chaseab/so101-toolchanger/docs/future_tools/README.md

# Future tools

Tools designed for the changer: Jenga pusher JG2, hand HI5F, stamp STAMP2 and fin-ray gripper FR1. FR1 is built and runs on the changer; the other three are designs only. The focus of this repo is the tool changer itself, see the main README.
