chaseab/so101-toolchanger/docs/future_tools/fr1_exploded.png

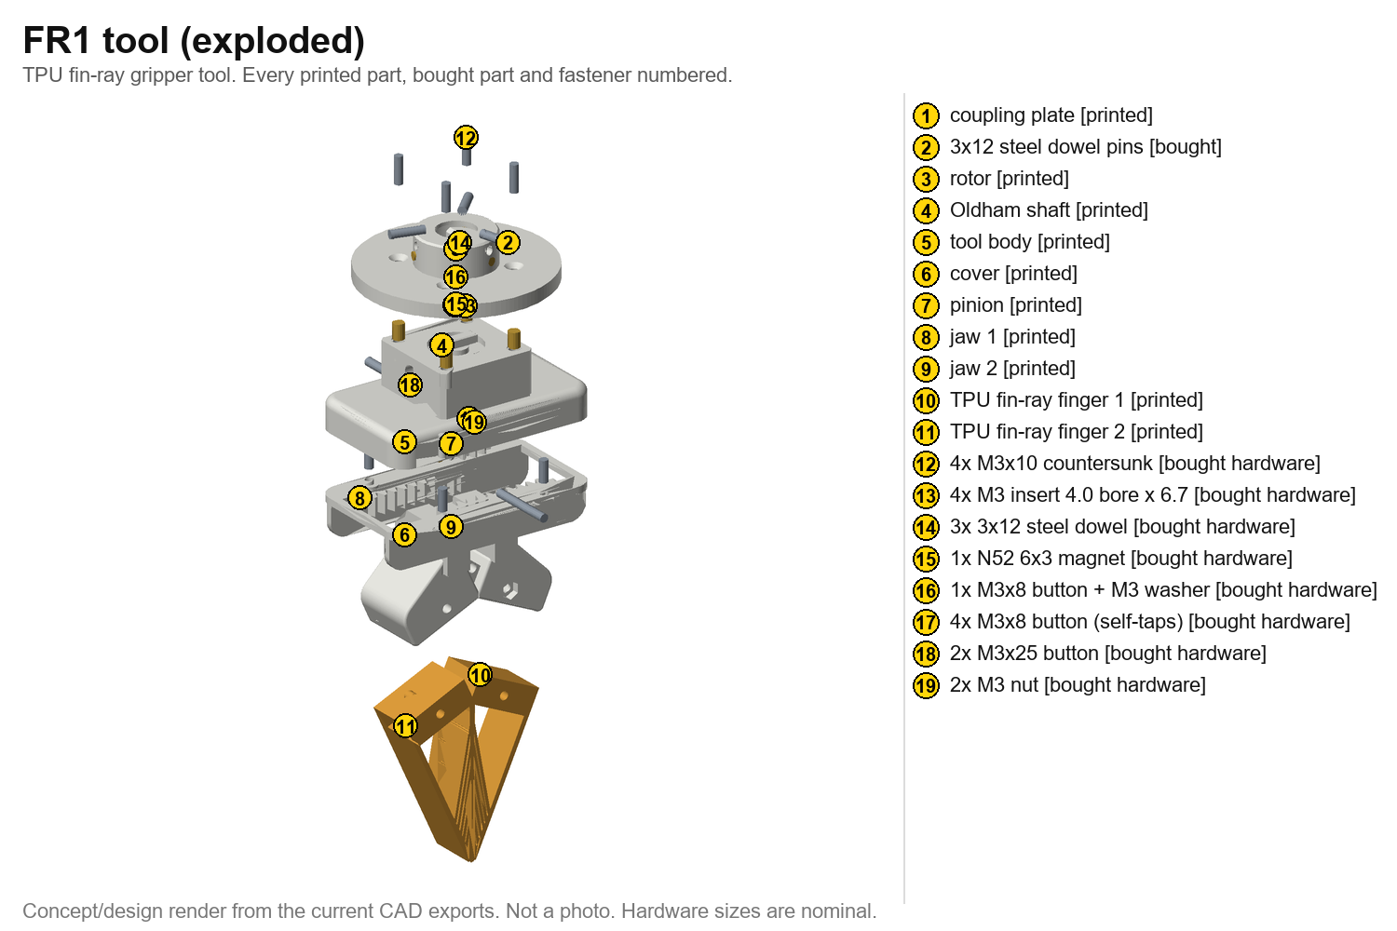
docs/future_tools/fr1_exploded.png
