chaseab/so101-toolchanger/docs/future_tools/hi5f_exploded.png

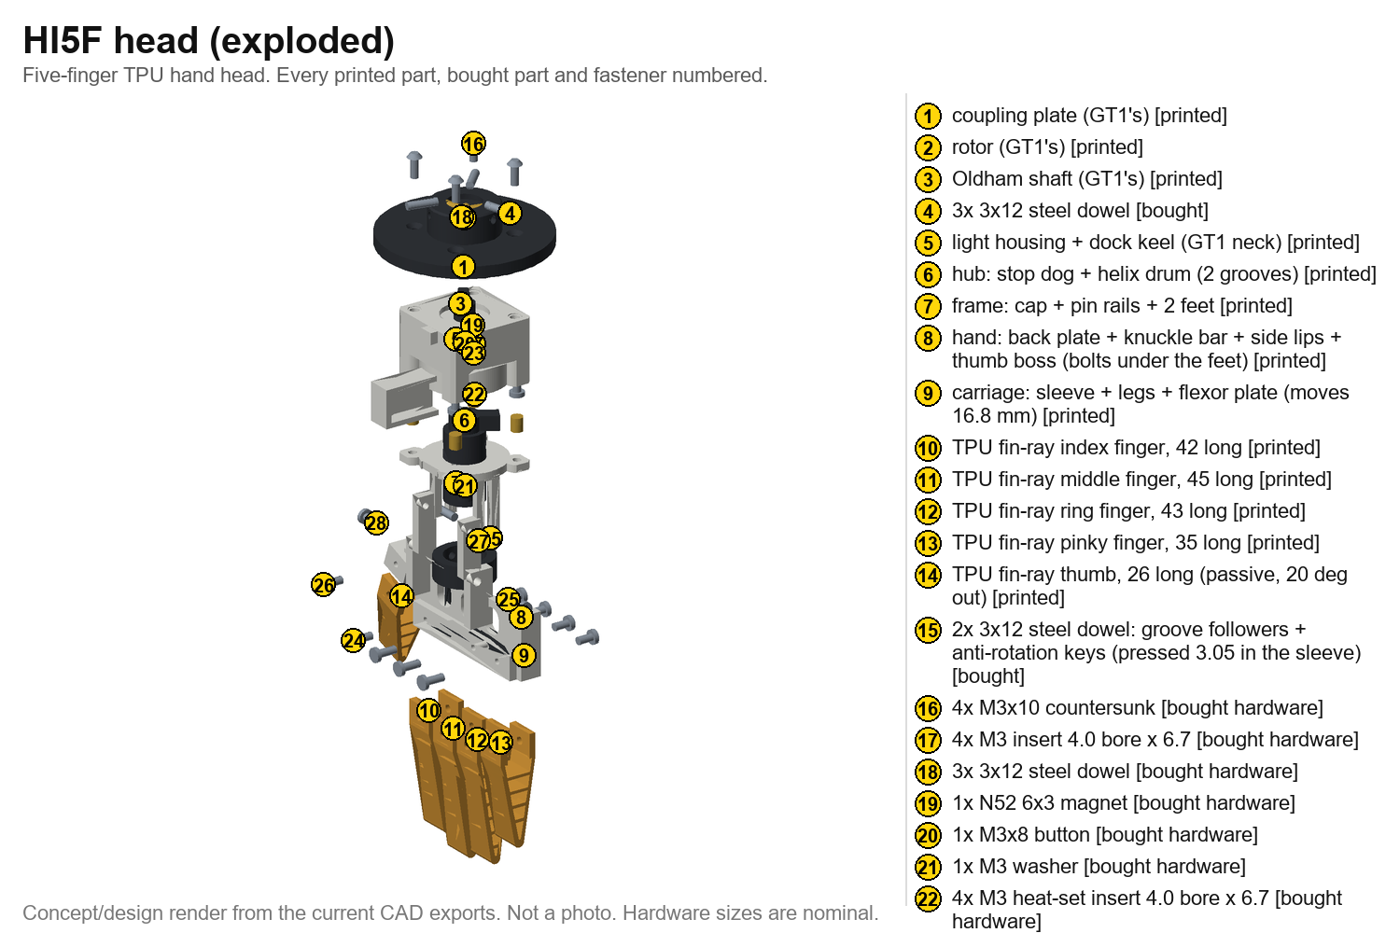
docs/future_tools/hi5f_exploded.png
