chaseab/so101-toolchanger/docs/future_tools/jg2_exploded.png

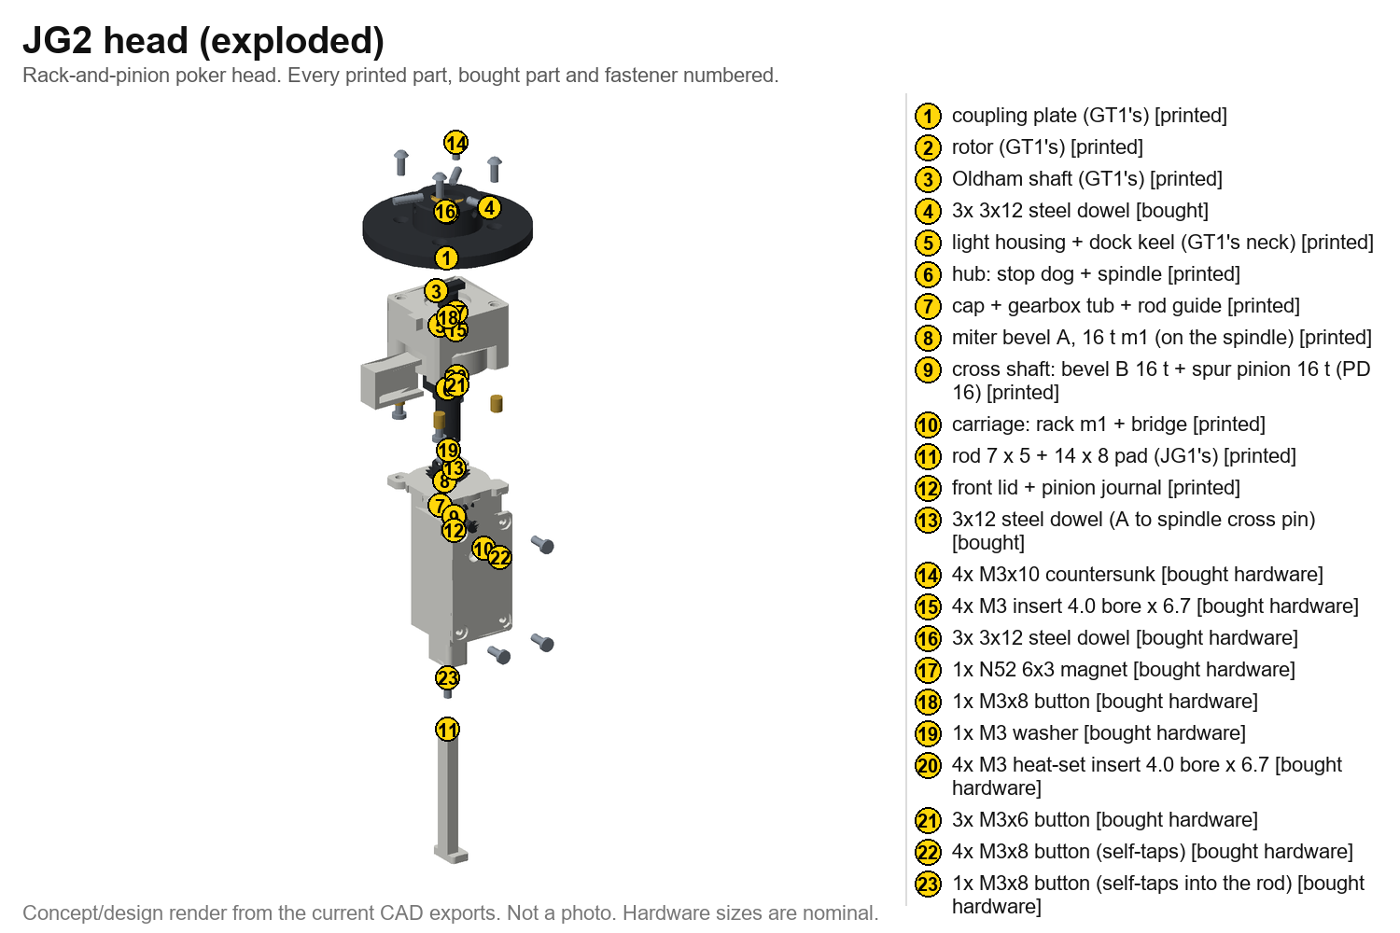
docs/future_tools/jg2_exploded.png
