chaseab/so101-toolchanger/docs/future_tools/stamp2_exploded.png

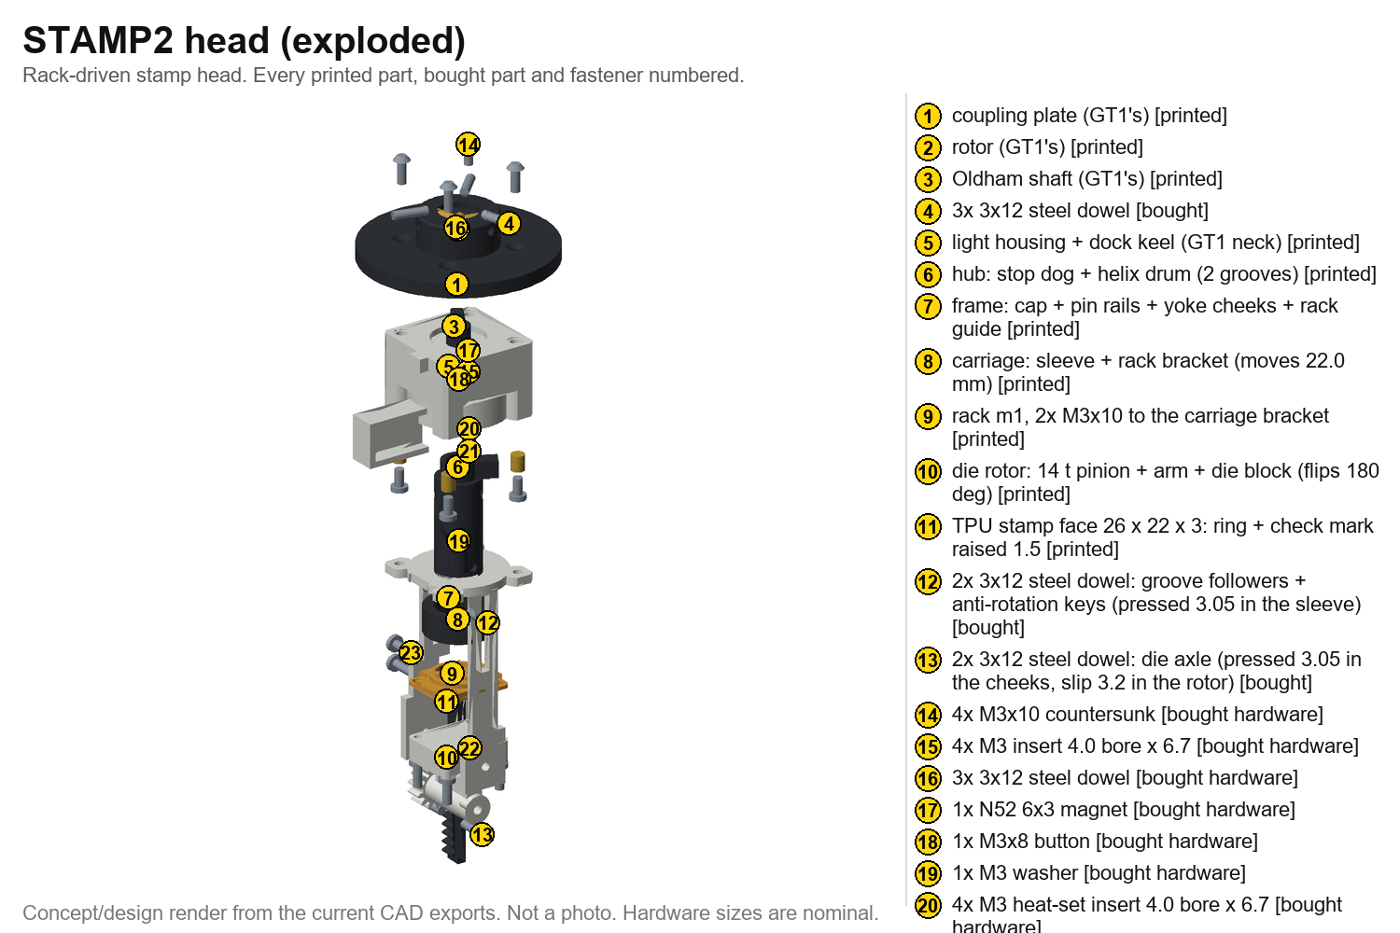
docs/future_tools/stamp2_exploded.png
