chaseab/so101-toolchanger/docs/BOM.csv

section | part_id | part | qty | spec | used_for | source_type | vendor | link | exact_url | generic_url | search_q | grams_each | filament | approx_price_usd
A | tc-so101-arm | SO-101 arm (follower), TheRobotStudio design | 1 | SO-ARM100 / SO-101 repo: printed parts, STS3215 servos, controller board | the arm the changer mounts on | upstream | TheRobotStudio | https://logicframeco.com/go/tc-so101-arm/github | https://github.com/TheRobotStudio/SO-ARM100 |  |  |  |  | ~
A | tc-dowel-3x12 | Steel dowel pin, plain cylindrical 3 mm x 12 mm (pack of 50) | 9 | 3 mm dia x 12 mm, 304 stainless, unthreaded | steel V-seats on the arm-side ring (6) and the pins on the tool coupler plate (3) | bought | Amazon (MroMax) | https://logicframeco.com/go/tc-dowel-3x12/github | https://www.amazon.com/dp/B07ZF3478S | https://www.amazon.com/s?k=3mm+x+12mm+stainless+steel+dowel+pins+50+pcs | 3mm x 12mm stainless steel dowel pins 50 pcs |  |  | 5.99
A | tc-magnet-n52-6x3 | N52 neodymium disc magnet 6 mm x 3 mm (pack of 50) | 2 | 6 x 3 mm, N52 | one in the tool neck and one in the dock floor, so a parked tool is not dragged out | bought | Amazon | https://logicframeco.com/go/tc-magnet-n52-6x3/github | https://www.amazon.com/dp/B0GWM33Z8X | https://www.amazon.com/s?k=N52+neodymium+disc+magnets+6x3mm+50+pcs | N52 neodymium disc magnets 6x3mm 50 pcs |  |  | 14.59
A | tc-ball-5-32 | Chrome steel ball 5/32 in (3.97 mm), G25 (pack of 100) | 3 | 5/32 in, G25 chrome steel, non-magnetic | tips of the three spring plungers on the arm side | bought | Amazon (PGN) | https://logicframeco.com/go/tc-ball-5-32/github | https://www.amazon.com/dp/B07D9SHZRZ | https://www.amazon.com/s?k=5%2F32+inch+G25+chrome+steel+balls+100+pcs | 5/32 inch G25 chrome steel balls 100 pcs |  |  | 7.95
A | tc-spring-5x0.7x10 | Compression spring 5 mm OD x 0.7 mm wire x 10 mm free (pack of 10) | 3 | 5 mm OD, 0.7 mm wire, 10 mm free, 304 stainless; about 10 N at 8.05 mm | push the three plungers (and the tool plate back) in the twist-lock | bought | Amazon (MECCANIXITY) | https://logicframeco.com/go/tc-spring-5x0.7x10/github | https://www.amazon.com/dp/B0DX21BNJM | https://www.amazon.com/s?k=compression+spring+5mm+OD+0.7mm+wire+10mm+free+length | compression spring 5mm OD 0.7mm wire 10mm free length |  |  | 6.59
A | tc-m3x10-csk | M3 x 10 countersunk (flat head) hex socket screw, 90 deg (pack of 50) | 8 | M3 x 10, 304 stainless, countersunk | hold the coupling plate to the tool neck (4) and the clamp bars to the dock frame (4) | bought | Amazon | https://logicframeco.com/go/tc-m3x10-csk/github | https://www.amazon.com/dp/B0H3GL2FSM | https://www.amazon.com/s?k=M3+x+10+countersunk+flat+head+hex+socket+screws | M3 x 10 countersunk flat head hex socket screws |  |  | 5.99
A | tc-m3-heat-insert-4.0x6.7 | M3 brass heat-set insert, 4.0 bore x 6.7 L | 15 | M3 thread, 4.0 mm bore, 6.7 mm long | threaded holes in the arm-side hub, ring and cage (7), the tool neck (4) and the dock frame (4) | generic | Amazon (FFVRVSS 600-pc set) | https://logicframeco.com/go/tc-m3-heat-insert-4.0x6.7/github | none | https://www.amazon.com/s?k=M3+x+5.7+x+4+brass+heat+set+insert | M3 x 5.7 x 4 brass heat set insert |  |  | ~
A | tc-m3-button-master | M3 button-head socket screw, 5 to 8 mm (kit) | 13 | M3 ISO 7380 button head: 4x M3x6 (hub to roll horn), 5x M3x8 (ring to cage, strap), 4x M3x5 (carrier to gripper horn) | hold the arm-side parts together | generic | Amazon (Fgruh M2-M5 kit) | https://logicframeco.com/go/tc-m3-button-master/github | none | https://www.amazon.com/s?k=M3+button+head+socket+screws+assortment+kit | M3 button head socket screws assortment kit |  |  | ~
A | tc-m3x40-socket | M3 x 40 socket head cap screw | 2 | M3 x 40 hex socket | hold the servo cage up into the hub (2) | generic | Amazon (NIULUNBAO M3 20-40 mm kit) | https://logicframeco.com/go/tc-m3x40-socket/github | none | https://www.amazon.com/s?k=M3+x+40mm+socket+head+cap+screws | M3 x 40mm socket head cap screws |  |  | ~
A | tc-vhb-tape-disc | Double-sided tape disc D10 x 0.4 mm | 2 | 10 mm dia x 0.4 mm, cut from 1 in tape | stick the dock stop pads to the dock wall | generic | Amazon (Hasaky tape) | https://logicframeco.com/go/tc-vhb-tape-disc/github | none | https://www.amazon.com/s?k=double+sided+mounting+tape+1+inch+0.4mm | double sided mounting tape 1 inch 0.4mm |  |  | ~
A | tc-vhb-tape-strip | Double-sided tape strip 23.6 x 14.8 x 0.4 mm | 2 | 23.6 x 14.8 x 0.4 mm, cut from 1 in tape | stick the dock cradle columns to the dock foot | generic | Amazon (Hasaky tape) | https://logicframeco.com/go/tc-vhb-tape-strip/github | none | https://www.amazon.com/s?k=double+sided+mounting+tape+1+inch+0.4mm | double sided mounting tape 1 inch 0.4mm |  |  | ~
A | tc-ptfe-grease | PTFE grease, 0.75 oz tube | 1 | all-purpose PTFE grease | light coat on the locking surfaces | generic | Amazon (Magnalube-G) | https://logicframeco.com/go/tc-ptfe-grease/github | none | https://www.amazon.com/s?k=Super+Lube+PTFE+grease+small+tube | Super Lube PTFE grease small tube |  |  | 11.99
A | tc-ca-glue | Cyanoacrylate gel glue | 1 | clear CA gel | glue the steel dowels and the lead-in skirt | generic | Amazon (Loctite Ultra Gel) | https://logicframeco.com/go/tc-ca-glue/github | none | https://www.amazon.com/s?k=Loctite+super+glue+ultra+gel | Loctite super glue ultra gel |  |  | 4.73
A | tc-pla-black | PLA filament 1.75 mm, black (2 x 1 kg) | 1 | 1.75 mm PLA | most printed parts | bought | Amazon (ELEGOO) | https://logicframeco.com/go/tc-pla-black/github | https://www.amazon.com/dp/B0BM7465PB | https://www.amazon.com/s?k=ELEGOO+PLA+filament+1.75mm+black | ELEGOO PLA filament 1.75mm black |  |  | 23.73
A | tc-pla-white | PLA filament 1.75 mm, white | 1 | 1.75 mm PLA | dock retrofit kit prints | generic | Amazon (ELEGOO black/white 4 kg) | https://logicframeco.com/go/tc-pla-white/github | none | https://www.amazon.com/s?k=ELEGOO+PLA+filament+1.75mm+white | ELEGOO PLA filament 1.75mm white |  |  | ~
A | tc-tpu-95a | TPU 95A filament 1.75 mm | 1 | 1.75 mm TPU 95A | the two small pads on the arm-side servo cage | generic | Amazon (Polymaker) | https://logicframeco.com/go/tc-tpu-95a/github | none | https://www.amazon.com/s?k=Polymaker+TPU+95A+1.75mm+filament+black | Polymaker TPU 95A 1.75mm filament black |  |  | ~
A | tc-master-master-hub-v4 | Hub | 1 | printed, ~11.6 g PLA each | arm side: bolts to the wrist-roll horn | printed |  | stl/master_v4/master_hub_v4.stl |  |  |  | 11.6 | PLA | ~
A | tc-master-master-cage-v4 | Servo cage | 1 | printed, ~35.6 g PLA each | arm side: holds the gripper servo | printed |  | stl/master_v4/master_cage_v4.stl |  |  |  | 35.6 | PLA | ~
A | tc-master-master-strap-v4 | Hold-down strap | 1 | printed, ~2.4 g PLA each | arm side: holds the servo in the cage | printed |  | stl/master_v4/master_strap_v4.stl |  |  |  | 2.4 | PLA | ~
A | tc-master-master-carrier-v4 | Blade carrier | 1 | printed, ~1.8 g PLA each | arm side: the blade that turns the tool rotor | printed |  | stl/master_v4/master_carrier_v4.stl |  |  |  | 1.8 | PLA | ~
A | tc-master-master-ring-v4q | Coupling ring | 1 | printed, ~45.5 g PLA each | arm side: the three V-seats and windows of the twist-lock | printed |  | stl/master_v4/master_ring_v4q.stl |  |  |  | 45.5 | PLA | ~
A | tc-master-master-skirt-v4 | Lead-in skirt | 1 | printed, ~13.4 g PLA each | arm side: guides the tool plate in | printed |  | stl/master_v4/master_skirt_v4.stl |  |  |  | 13.4 | PLA | ~
A | tc-master-master-backpad-tpu-v4 | Back pad | 1 | printed, ~1.0 g TPU each | arm side: stops the servo lifting | printed |  | stl/master_v4/master_backpad_TPU_v4.stl |  |  |  | 1.0 | TPU | ~
A | tc-master-master-farpad-tpu-v4 | Far pad shim | 1 | printed, ~0.2 g TPU each | arm side: shim under the strap | printed |  | stl/master_v4/master_farpad_TPU_v4.stl |  |  |  | 0.2 | TPU | ~
A | tc-master-master-plunger0-v4b | Ball plunger (3 identical; the other two STLs are the same part at the other seats) | 3 | printed, ~0.2 g PLA each | arm side: carries the steel ball and spring | printed |  | stl/master_v4/master_plunger0_v4b.stl |  |  |  | 0.2 | PLA | ~
A | tc-gt1-gt-plate | Coupling plate | 1 | printed, ~25.3 g PLA each | tool coupler: the plate with the three pins that locks into the ring | printed |  | stl/tool_gt1/gt_plate.stl |  |  |  | 25.3 | PLA | ~
A | tc-gt1-gt-rotor | Floating rotor | 1 | printed, ~3.8 g PLA each | tool coupler: the arm blade drives this | printed |  | stl/tool_gt1/gt_rotor.stl |  |  |  | 3.8 | PLA | ~
A | tc-gt1-gt-shaft | Drive shaft | 1 | printed, ~1.5 g PLA each | tool coupler: carries the rotor turn into the tool | printed |  | stl/tool_gt1/gt_shaft.stl |  |  |  | 1.5 | PLA | ~
A | tc-dock-dock-post-asbuilt | Dock post (the same part is also exported as dock_post_v4) | 1 | printed, ~326.3 g PLA each | dock: the slotted wall that parks the tool | printed |  | stl/dock_v5/dock_post_asbuilt.stl |  |  |  | 326.3 | PLA | ~
A | tc-dock-db-frame | Dock table frame | 1 | printed, ~86.9 g PLA each | dock: base that clamps to the table | printed |  | stl/master_v4/db_frame.stl |  |  |  | 86.9 | PLA | ~
A | tc-dock-db-bar-front | Front clamp bar | 1 | printed, ~25.1 g PLA each | dock: clamps the post, arm side | printed |  | stl/master_v4/db_bar_front.stl |  |  |  | 25.1 | PLA | ~
A | tc-dock-db-bar-back | Back clamp bar | 1 | printed, ~17.5 g PLA each | dock: clamps the post, back side | printed |  | stl/master_v4/db_bar_back.stl |  |  |  | 17.5 | PLA | ~
A | tc-dock-v5-cradle-col-l | R1 cradle column, left | 1 | printed, ~23.7 g PLA each | dock R1 kit: guides the tool body into the dock | printed |  | stl/dock_v5/cradle_col_L.stl |  |  |  | 23.7 | PLA | ~
A | tc-dock-v5-cradle-col-r | R1 cradle column, right | 1 | printed, ~23.7 g PLA each | dock R1 kit: guides the tool body into the dock | printed |  | stl/dock_v5/cradle_col_R.stl |  |  |  | 23.7 | PLA | ~
A | tc-dock-v5-stop-pad | R1 stop pad, D10 round (2 needed) | 2 | printed, ~0.2 g PLA each | dock R1 kit: sets the plate gap to the wall | printed |  | stl/dock_v5/stop_pad.stl |  |  |  | 0.2 | PLA | ~
A | tc-dock-v5-t-gauge | R1 T-gauge (one-time alignment template) | 1 | printed, ~19.6 g PLA each | dock R1 kit: lines the dock up with the arm | printed |  | stl/dock_v5/t_gauge.stl |  |  |  | 19.6 | PLA | ~
B | tc-dowel-3x12 | Steel dowel pin, plain cylindrical 3 mm x 12 mm (pack of 50) | 3 | 3 mm dia x 12 mm, 304 stainless, unthreaded | the three pins on the new tool's coupler plate | bought | Amazon (MroMax) | https://logicframeco.com/go/tc-dowel-3x12/github | https://www.amazon.com/dp/B07ZF3478S | https://www.amazon.com/s?k=3mm+x+12mm+stainless+steel+dowel+pins+50+pcs | 3mm x 12mm stainless steel dowel pins 50 pcs |  |  | 5.99
B | tc-magnet-n52-6x3 | N52 neodymium disc magnet 6 mm x 3 mm (pack of 50) | 1 | 6 x 3 mm, N52 | one in the new tool's neck | bought | Amazon | https://logicframeco.com/go/tc-magnet-n52-6x3/github | https://www.amazon.com/dp/B0GWM33Z8X | https://www.amazon.com/s?k=N52+neodymium+disc+magnets+6x3mm+50+pcs | N52 neodymium disc magnets 6x3mm 50 pcs |  |  | 14.59
B | tc-m3x10-csk | M3 x 10 countersunk (flat head) hex socket screw, 90 deg (pack of 50) | 4 | M3 x 10, 304 stainless, countersunk | hold the coupling plate to the new tool's neck | bought | Amazon | https://logicframeco.com/go/tc-m3x10-csk/github | https://www.amazon.com/dp/B0H3GL2FSM | https://www.amazon.com/s?k=M3+x+10+countersunk+flat+head+hex+socket+screws | M3 x 10 countersunk flat head hex socket screws |  |  | 5.99
B | tc-m3-heat-insert-4.0x6.7 | M3 brass heat-set insert, 4.0 bore x 6.7 L | 4 | M3 thread, 4.0 mm bore, 6.7 mm long | threaded holes in the new tool's neck | generic | Amazon (FFVRVSS 600-pc set) | https://logicframeco.com/go/tc-m3-heat-insert-4.0x6.7/github | none | https://www.amazon.com/s?k=M3+x+5.7+x+4+brass+heat+set+insert | M3 x 5.7 x 4 brass heat set insert |  |  | ~
B | tc-gt1-gt-plate | Coupling plate | 1 | printed, ~25.3 g PLA each | tool coupler: the plate with the three pins that locks into the ring | printed |  | stl/tool_gt1/gt_plate.stl |  |  |  | 25.3 | PLA | ~
B | tc-gt1-gt-rotor | Floating rotor | 1 | printed, ~3.8 g PLA each | tool coupler: the arm blade drives this | printed |  | stl/tool_gt1/gt_rotor.stl |  |  |  | 3.8 | PLA | ~
B | tc-gt1-gt-shaft | Drive shaft | 1 | printed, ~1.5 g PLA each | tool coupler: carries the rotor turn into the tool | printed |  | stl/tool_gt1/gt_shaft.stl |  |  |  | 1.5 | PLA | ~
C | tc-heat-insert-m3-5.0x4 | M3 brass heat-set insert, 5.0 OD x 4 L | 4 | M3 thread, 5.0 OD, 4 long | attach the optional R2 dock head (4) | generic | Amazon (FFVRVSS 600-pc set) | https://logicframeco.com/go/tc-heat-insert-m3-5.0x4/github | none | https://www.amazon.com/s?k=M3+x+4+brass+heat+set+insert+5mm+OD | M3 x 4 brass heat set insert 5mm OD |  |  | ~
C | tc-m3x10-button | M3 x 10 button-head socket screw | 4 | M3 x 10 ISO 7380 | attach the optional R2 dock head (4) | generic | Amazon (Fgruh M2-M5 kit) | https://logicframeco.com/go/tc-m3x10-button/github | none | https://www.amazon.com/s?k=M3+x+10+button+head+socket+screws | M3 x 10 button head socket screws |  |  | ~
C | tc-dock-v5-head-r2 | Optional R2 dock head (needs one jigsaw cut) | 1 | printed, ~79.3 g PLA each | optional dock head that replaces the old wall top | printed |  | stl/dock_v5/head_R2.stl |  |  |  | 79.3 | PLA | ~
