chaseab/so101-toolchanger/step/dock_v5/cradle_col_L.step

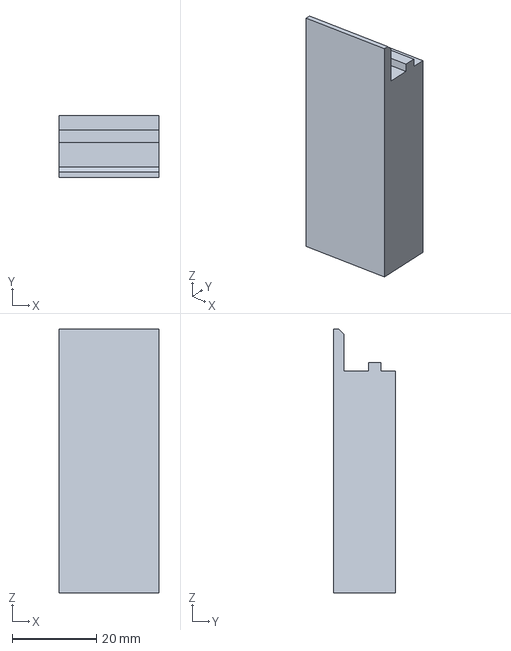
[picture p10: CAD file, 2026-10-30]
step/dock_v5/cradle_col_L.step
23.6 x 14.8 x 62.6 mm
