chaseab/so101-toolchanger/step/heads/jg2.step

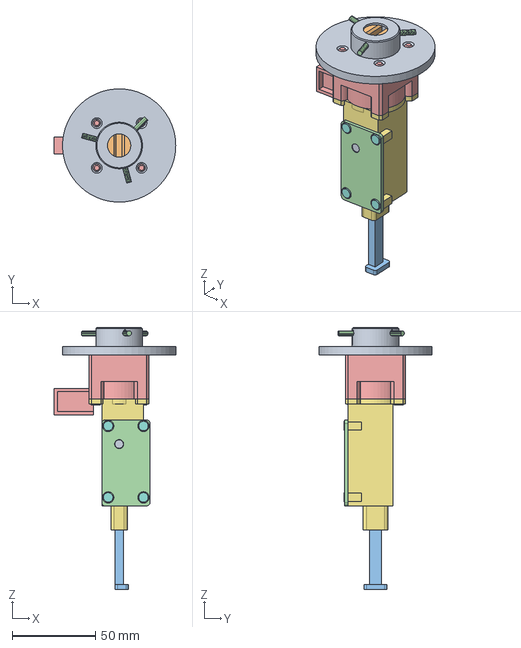
[picture p11: CAD file, 2026-10-30]
step/heads/jg2.step
73.0 x 68.0 x 157.3 mm
