chaseab/so101-toolchanger/step/master_v4/master_ring_v4.step

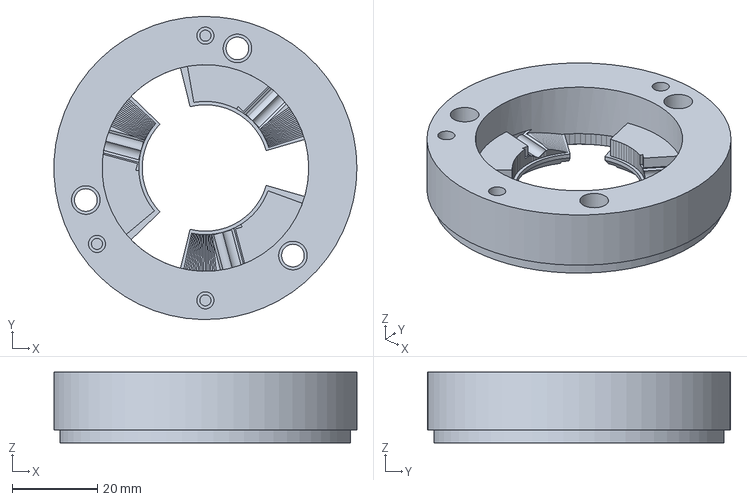
[picture p12: CAD file, 2026-10-30]
step/master_v4/master_ring_v4.step
70.9 x 71.0 x 16.5 mm
