chaseab/so101-toolchanger/step/tool_fr1/fr1.step

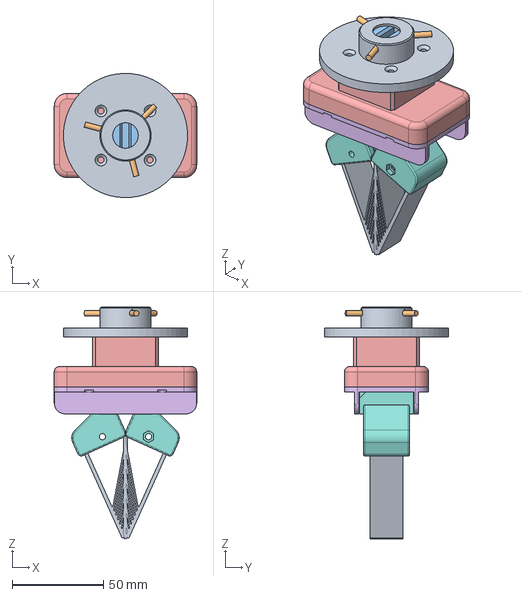
[picture p13: CAD file, 2026-10-30]
step/tool_fr1/fr1.step
78.0 x 68.0 x 127.0 mm
