chaseab/so101-toolchanger/stl/dock_v5/stop_pad_L.stl

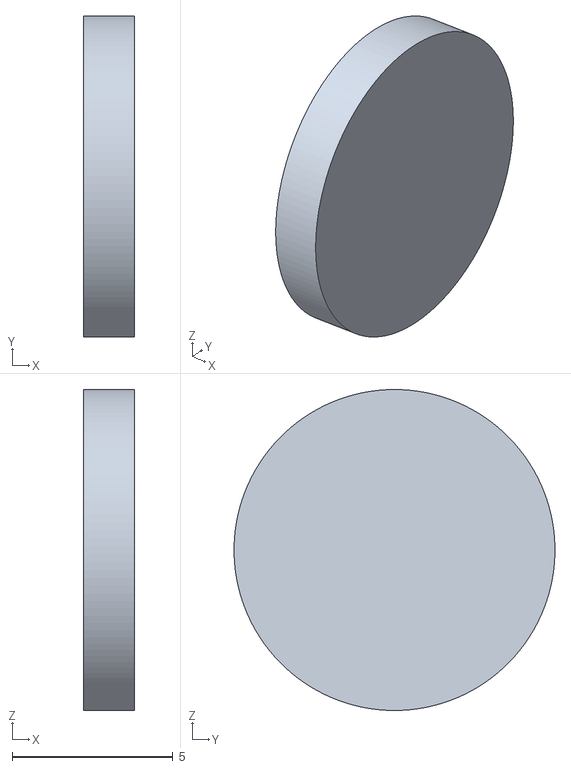
[picture p14: CAD file, 2026-10-30]
stl/dock_v5/stop_pad_L.stl
1.58 x 10.00 x 10.0
