chaseab/so101-toolchanger/stl/heads_hi5f/f_ring_closed.stl

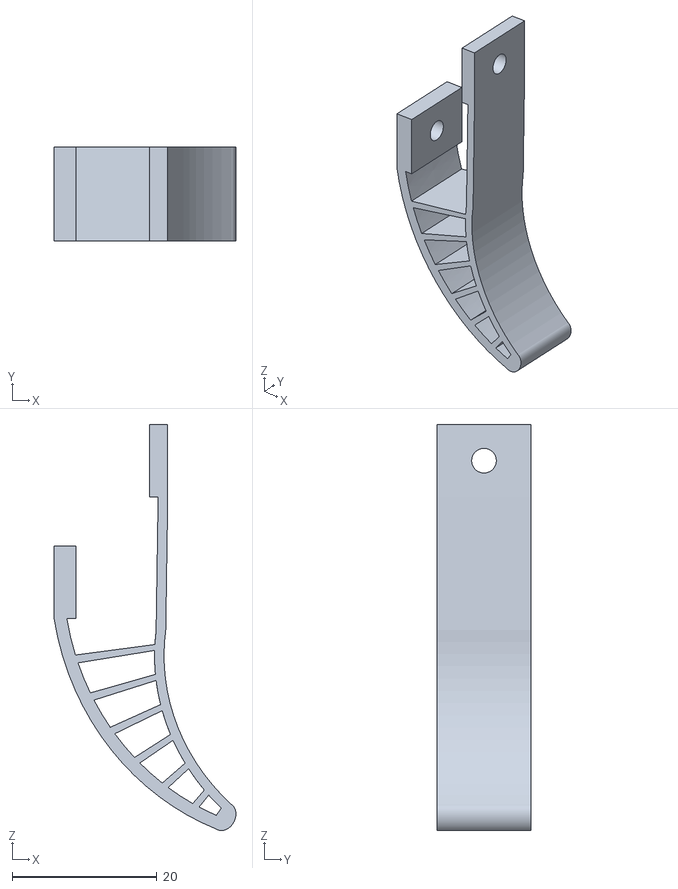
[picture p15: CAD file, 2026-10-30]
stl/heads_hi5f/f_ring_closed.stl
25.1 x 13.0 x 56.1
