chaseab/so101-toolchanger/stl/heads_jg2/pinion_unit.stl

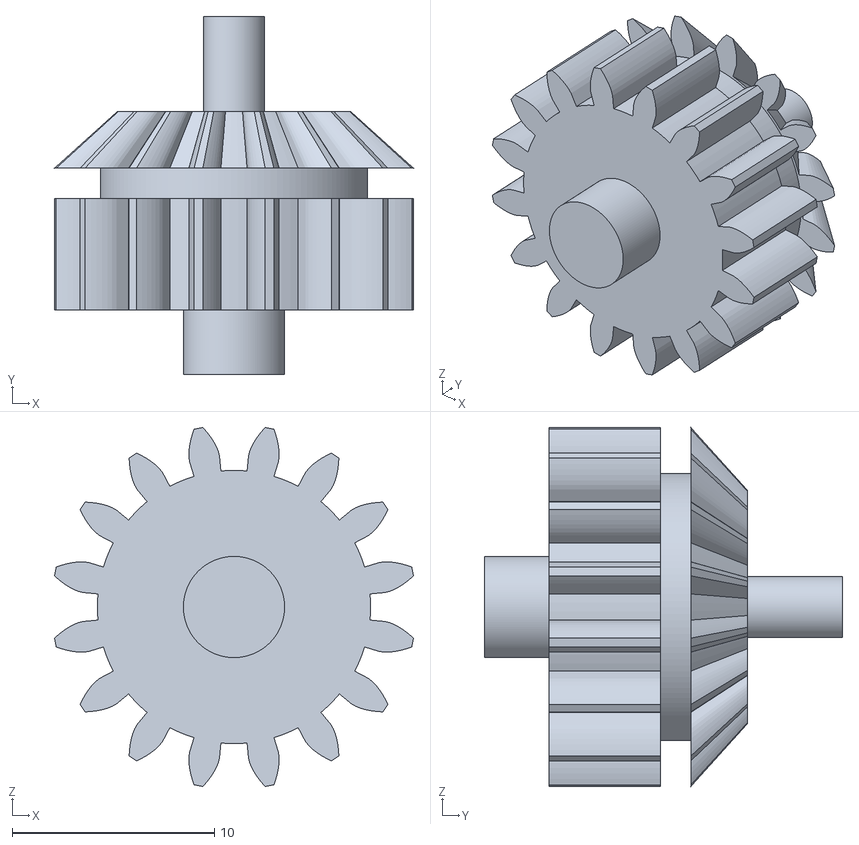
[picture p16: CAD file, 2026-10-30]
stl/heads_jg2/pinion_unit.stl
17.7 x 17.7 x 17.7
