chaseab/so101-toolchanger/stl/heads_stamp2/die_cap.stl

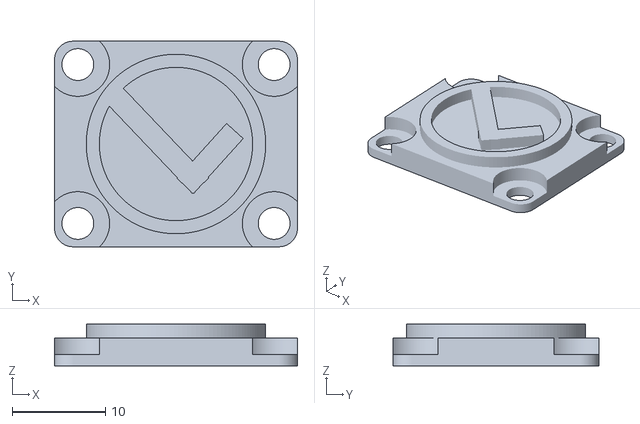
[picture p17: CAD file, 2026-10-30]
stl/heads_stamp2/die_cap.stl
26.0 x 22.0 x 4.49
