chaseab/so101-toolchanger/stl/master_v4/db_frame.stl

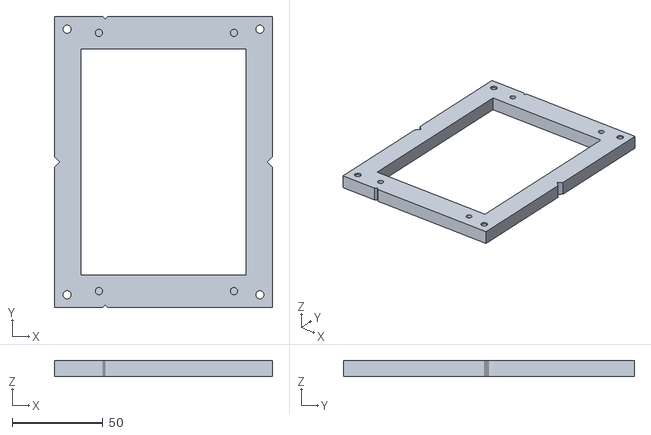
[picture p18: CAD file, 2026-10-30]
stl/master_v4/db_frame.stl
120.0 x 160.0 x 9.00
