chaseab/so101-toolchanger/stl/tool_fr1/jaw2_open.stl

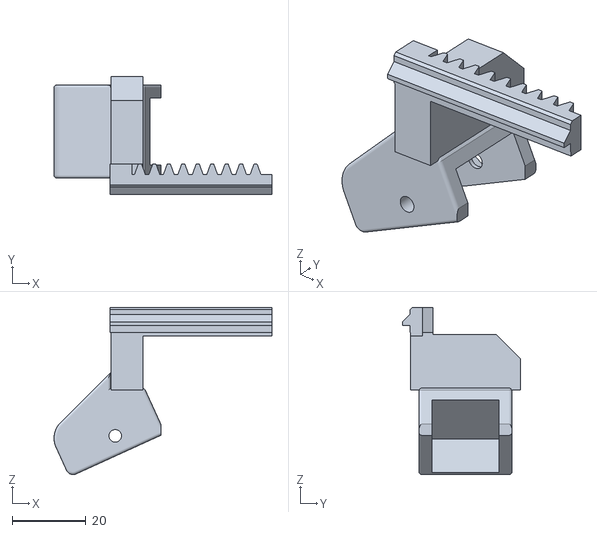
[picture p19: CAD file, 2026-10-30]
stl/tool_fr1/jaw2_open.stl
59.2 x 32.0 x 45.4
