chaseab/so101-toolchanger/stl/tool_gt1/gt_body.stl

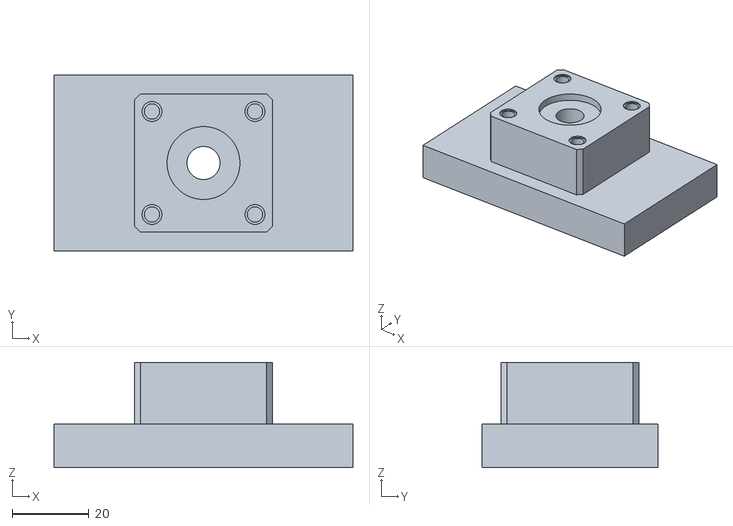
[picture p20: CAD file, 2026-10-30]
stl/tool_gt1/gt_body.stl
78.0 x 46.0 x 27.4
