chaseab/so101-toolchanger/step/heads/stamp2.step

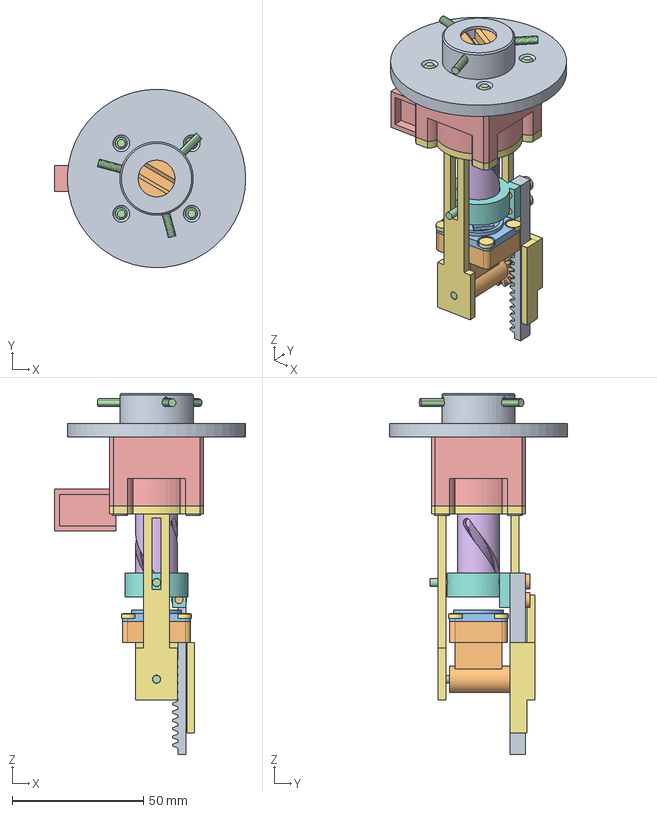
[picture p21: CAD file, 2026-10-30]
step/heads/stamp2.step
73.0 x 68.0 x 137.7 mm
