chaseab/so101-toolchanger/step/master_v4/dock_post_v4.step

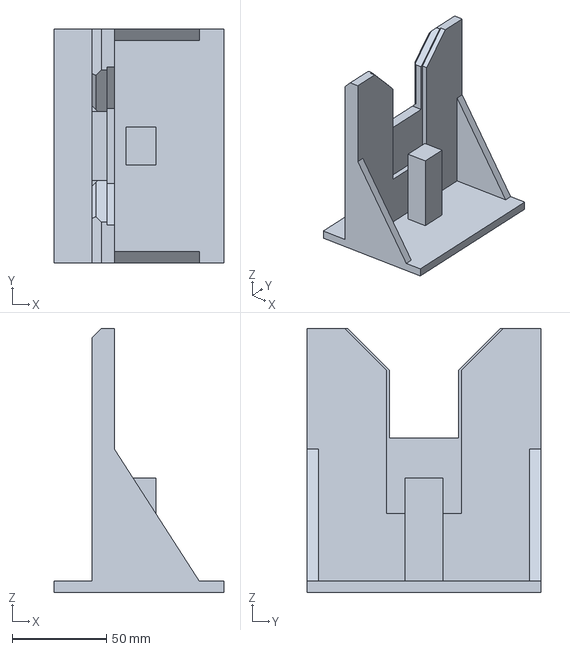
[picture p22: CAD file, 2026-10-30]
step/master_v4/dock_post_v4.step
90.0 x 124.0 x 140.0 mm
