chaseab/so101-toolchanger/stl/heads_hi5f/plate.stl

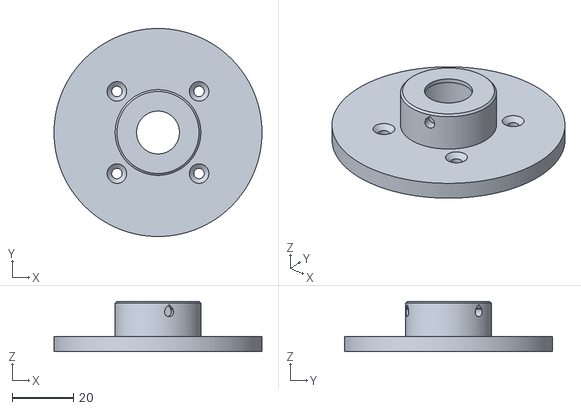
[picture p23: CAD file, 2026-10-30]
stl/heads_hi5f/plate.stl
68.0 x 68.0 x 16.5
