chaseab/so101-toolchanger/stl/heads_jg2/rod_ret.stl

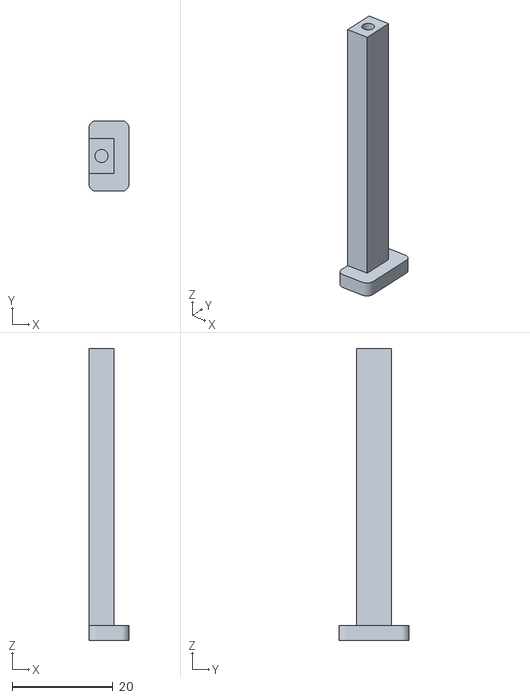
[picture p24: CAD file, 2026-10-30]
stl/heads_jg2/rod_ret.stl
8.00 x 14.0 x 58.0
