chaseab/so101-toolchanger/stl/heads_stamp2/hw_housing_insert1.stl

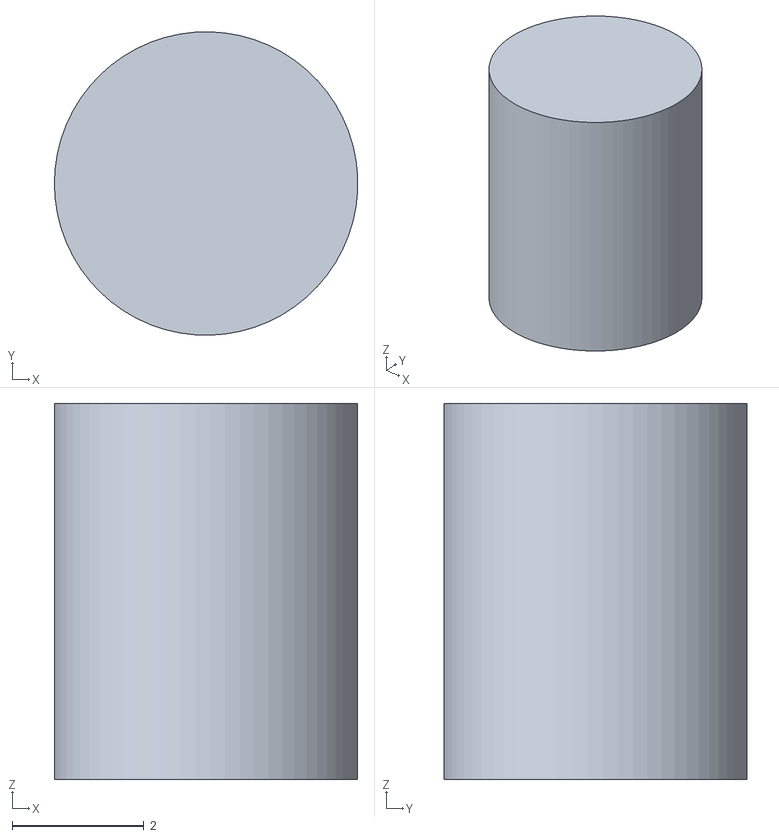
[picture p25: CAD file, 2026-10-30]
stl/heads_stamp2/hw_housing_insert1.stl
4.60 x 4.60 x 5.70
