chaseab/so101-toolchanger/stl/tool_fr1/pins.stl

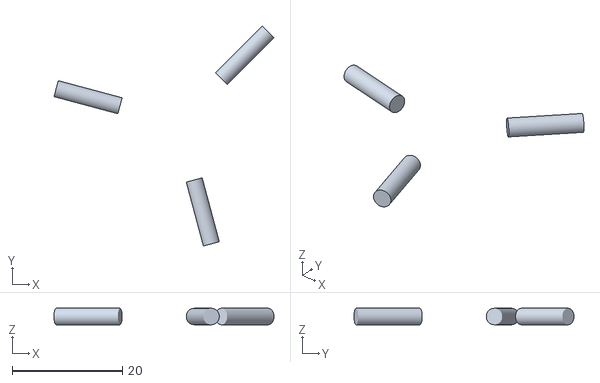
[picture p26: CAD file, 2026-10-30]
stl/tool_fr1/pins.stl
39.9 x 39.9 x 3.00
