chaseab/so101-toolchanger/stl/tool_gt1/gt_jaw1.stl

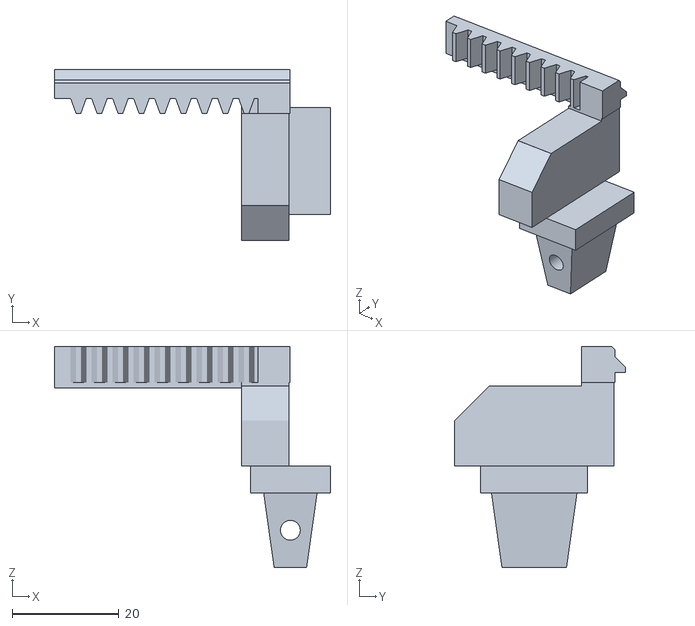
[picture p27: CAD file, 2026-10-30]
stl/tool_gt1/gt_jaw1.stl
51.6 x 32.0 x 41.4
