chaseab/so101-toolchanger/step/heads/hi5f.step

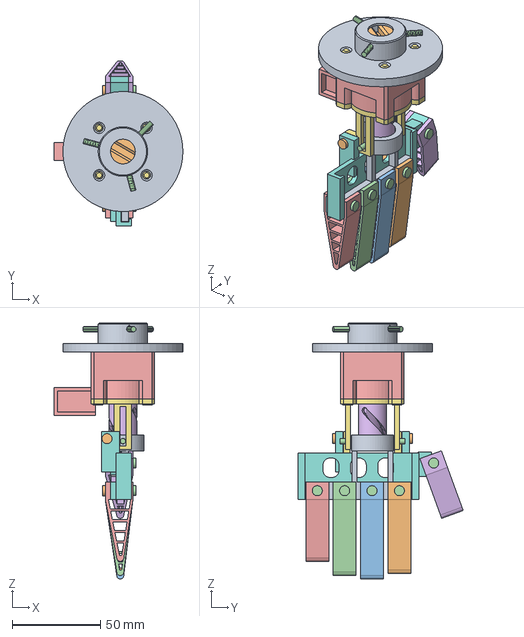
[picture p28: CAD file, 2026-10-30]
step/heads/hi5f.step
73.0 x 93.7 x 145.0 mm
