chaseab/so101-toolchanger/stl/heads_hi5f/housing.stl

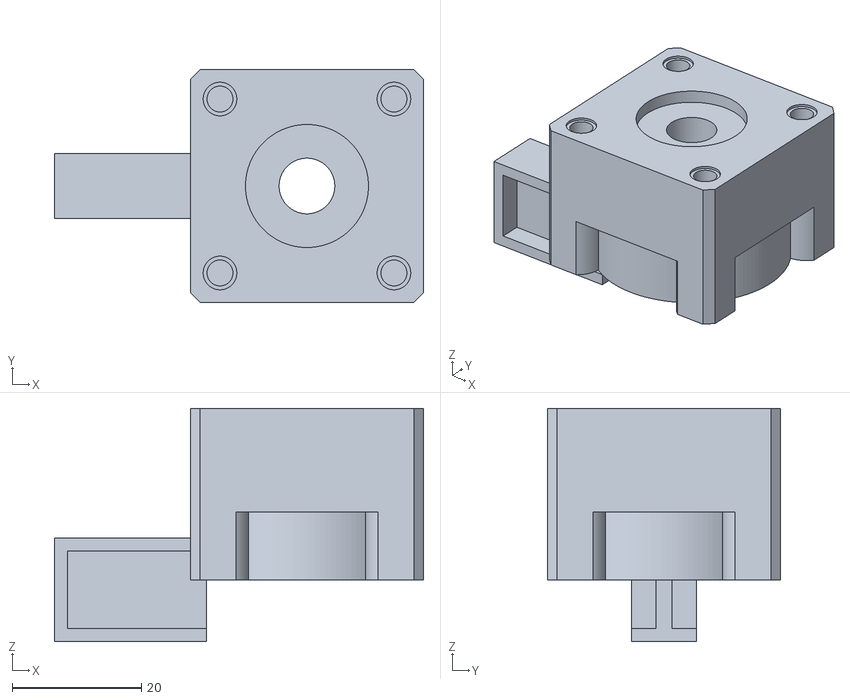
[picture p29: CAD file, 2026-10-30]
stl/heads_hi5f/housing.stl
57.0 x 36.0 x 36.0
