chaseab/so101-toolchanger/stl/master_v4/db_bar_back.stl

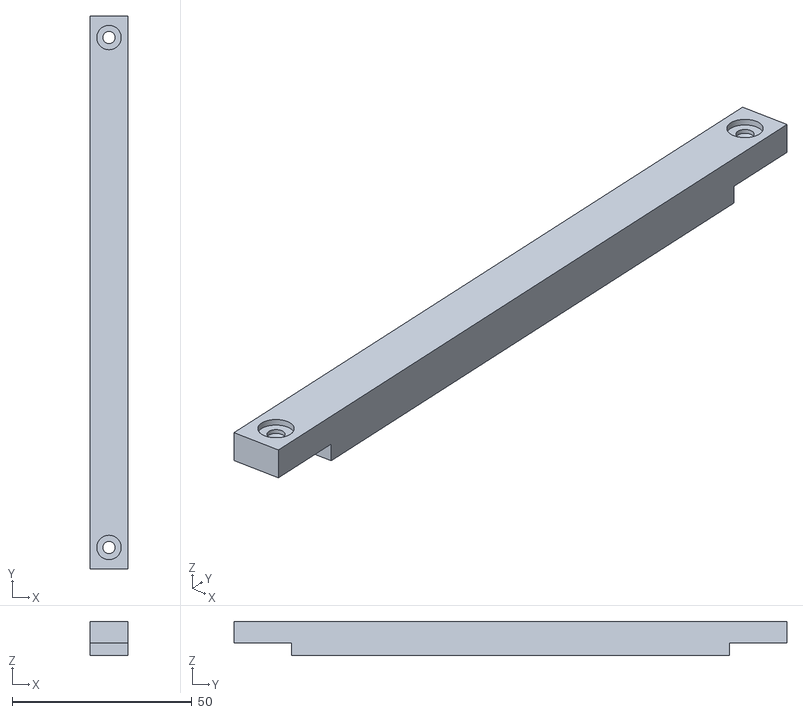
[picture p30: CAD file, 2026-10-30]
stl/master_v4/db_bar_back.stl
10.5 x 154.0 x 9.60
