chaseab/so101-toolchanger/stl/tool_gt1/gt_shaft.stl

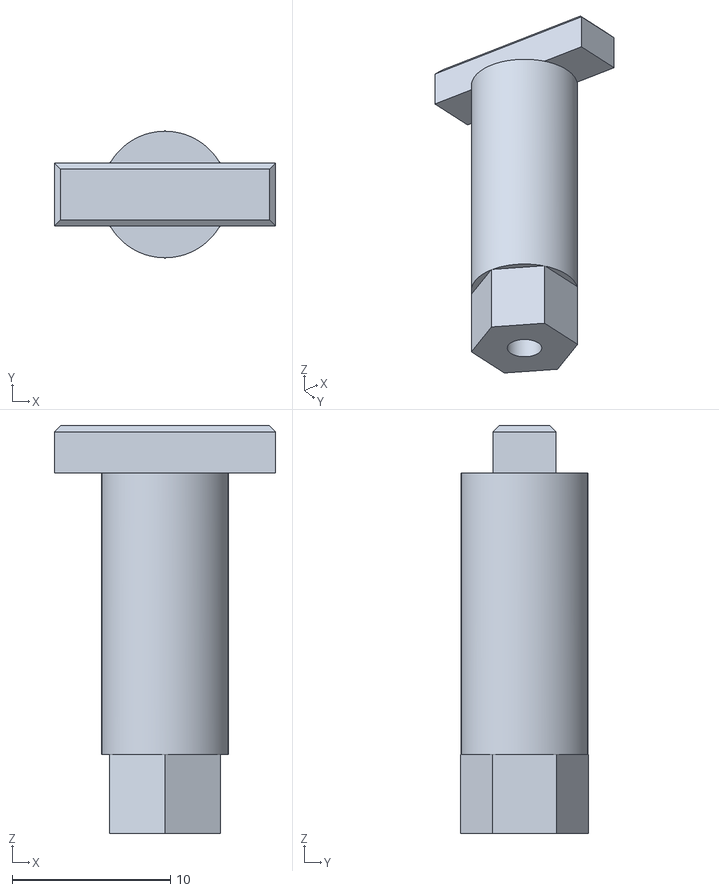
[picture p31: CAD file, 2026-10-30]
stl/tool_gt1/gt_shaft.stl
14.0 x 8.08 x 25.8
