chaseab/so101-toolchanger/step/dock_v5/t_gauge.step

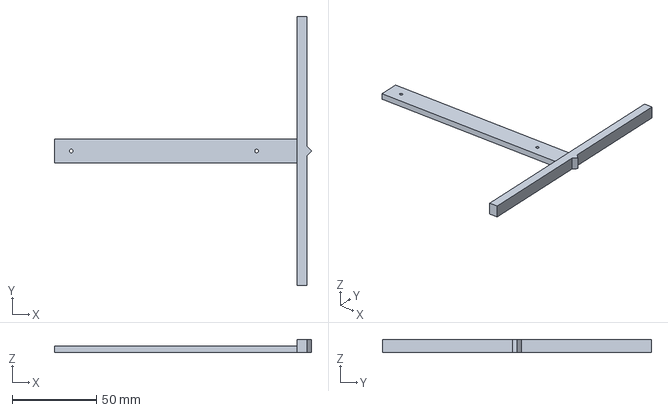
[picture p32: CAD file, 2026-10-30]
step/dock_v5/t_gauge.step
152.6 x 160.0 x 8.00 mm
