chaseab/so101-toolchanger/stl/master_v4/master_plunger2_v4b.stl

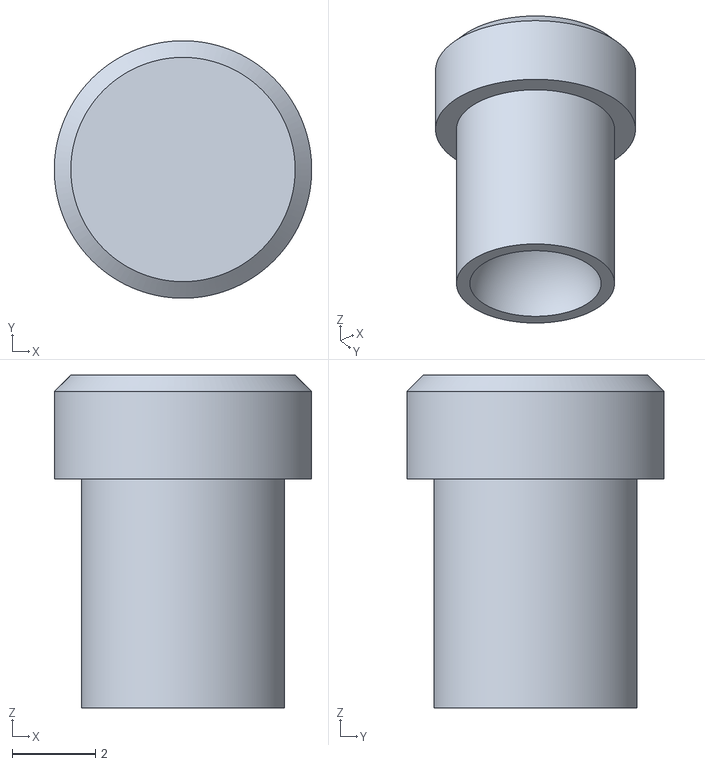
[picture p33: CAD file, 2026-10-30]
stl/master_v4/master_plunger2_v4b.stl
6.20 x 6.20 x 8.02
