chaseab/so101-toolchanger/stl/tool_fr1/body.stl

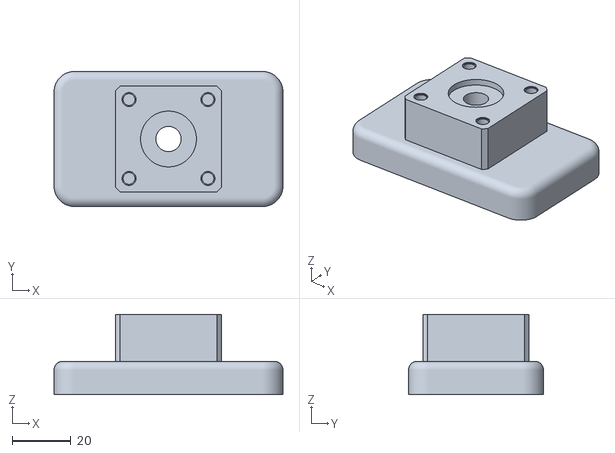
[picture p34: CAD file, 2026-10-30]
stl/tool_fr1/body.stl
78.0 x 46.0 x 27.4
