chaseab/so101-toolchanger/stl/tool_gt1/gt_finger.stl

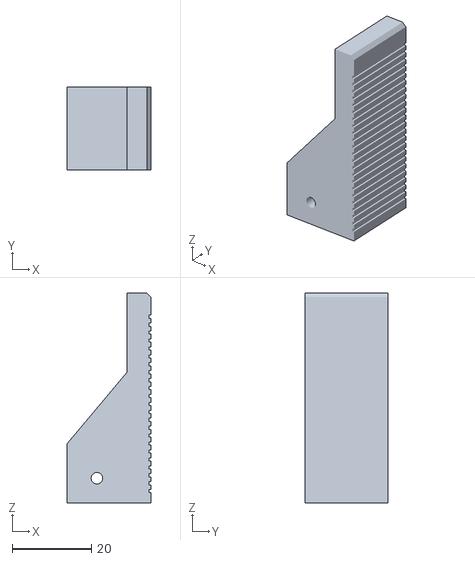
[picture p35: CAD file, 2026-10-30]
stl/tool_gt1/gt_finger.stl
21.1 x 21.0 x 53.0
