chaseab/so101-toolchanger/step/dock_v5/head_R2.step

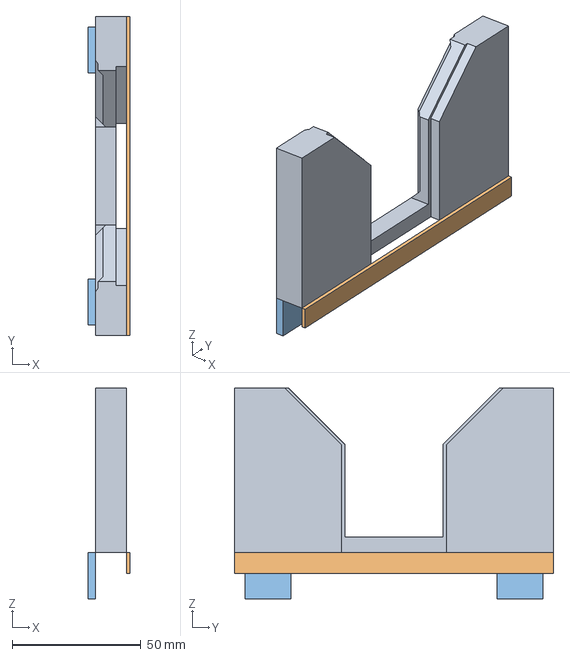
[picture p36: CAD file, 2026-10-30]
step/dock_v5/head_R2.step
16.5 x 124.0 x 82.0 mm
