chaseab/so101-toolchanger/stl/heads_jg2/hw_neck_magnet.stl

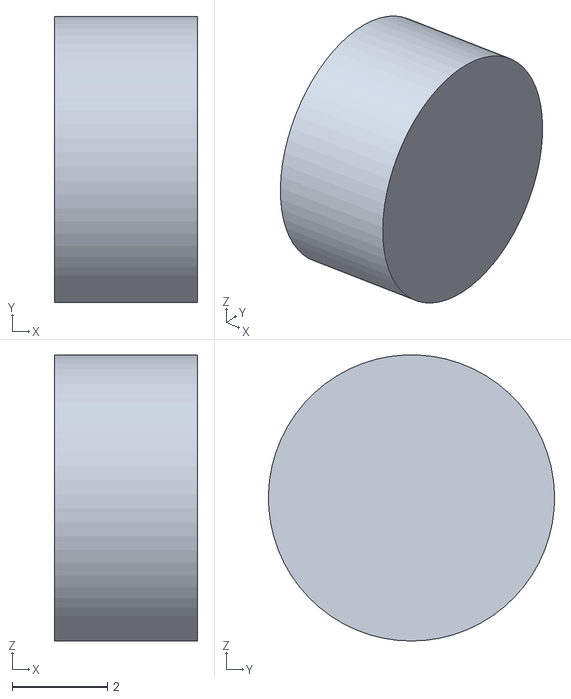
[picture p37: CAD file, 2026-10-30]
stl/heads_jg2/hw_neck_magnet.stl
3.00 x 6.00 x 6.00
