chaseab/so101-toolchanger/stl/master_v4/master_hub_v4.stl

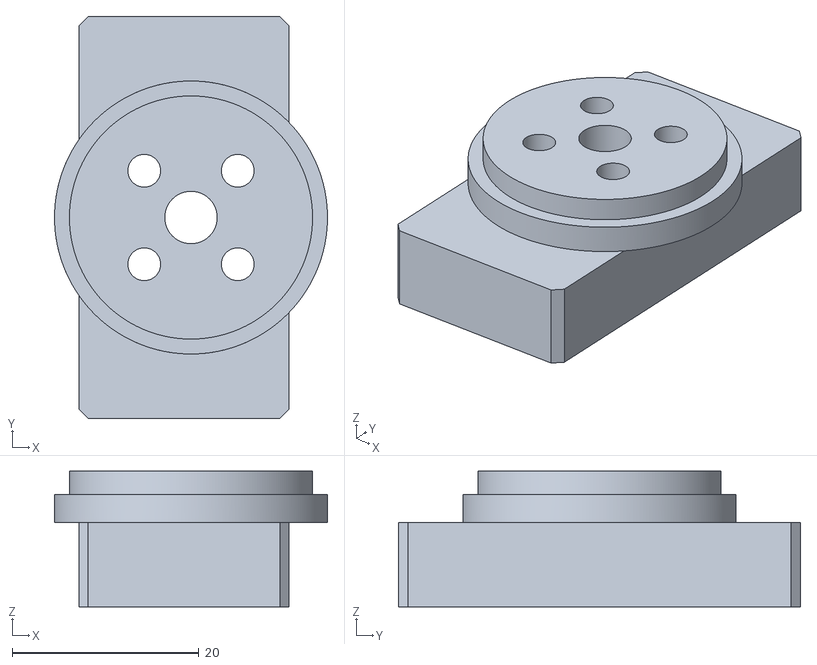
[picture p38: CAD file, 2026-10-30]
stl/master_v4/master_hub_v4.stl
29.2 x 43.0 x 14.5
