chaseab/so101-toolchanger/stl/tool_gt1/gt_cover.stl

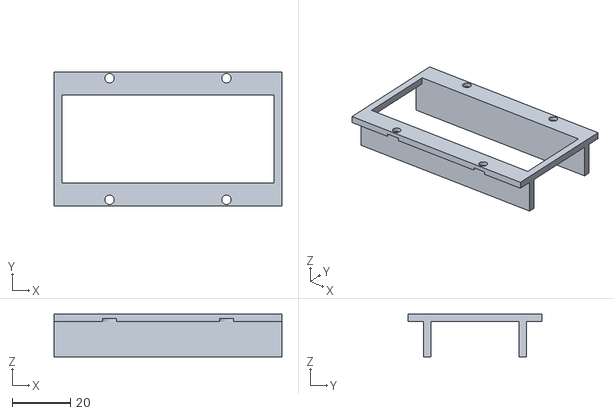
[picture p39: CAD file, 2026-10-30]
stl/tool_gt1/gt_cover.stl
78.0 x 46.0 x 14.6
