chaseab/so101-toolchanger/stl/heads_hi5f/f_pinky.stl

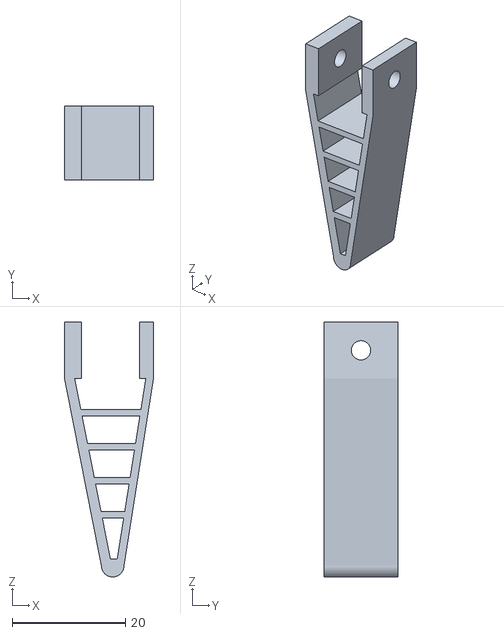
[picture p40: CAD file, 2026-10-30]
stl/heads_hi5f/f_pinky.stl
15.7 x 13.0 x 45.0
