chaseab/so101-toolchanger/stl/heads_jg2/bevel_a_ret.stl

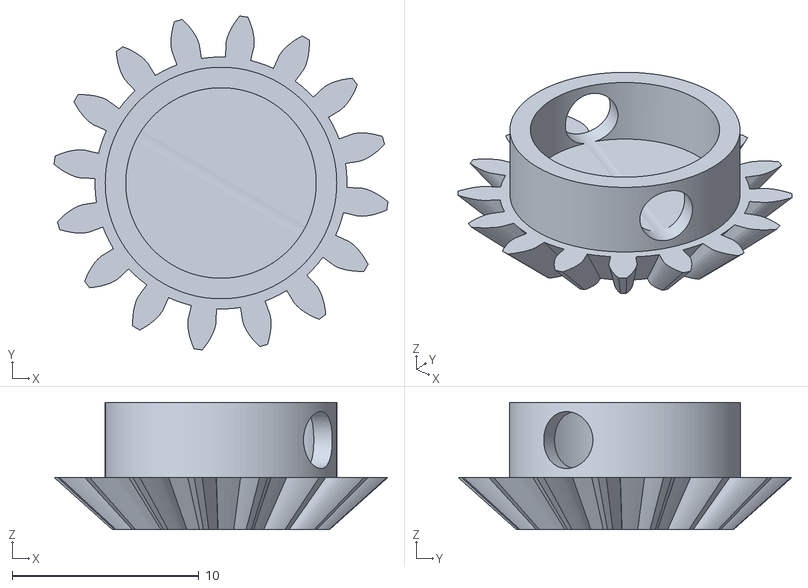
[picture p41: CAD file, 2026-10-30]
stl/heads_jg2/bevel_a_ret.stl
17.9 x 17.9 x 6.82
