chaseab/so101-toolchanger/stl/master_v4/master_farpad_PLA_v4.stl

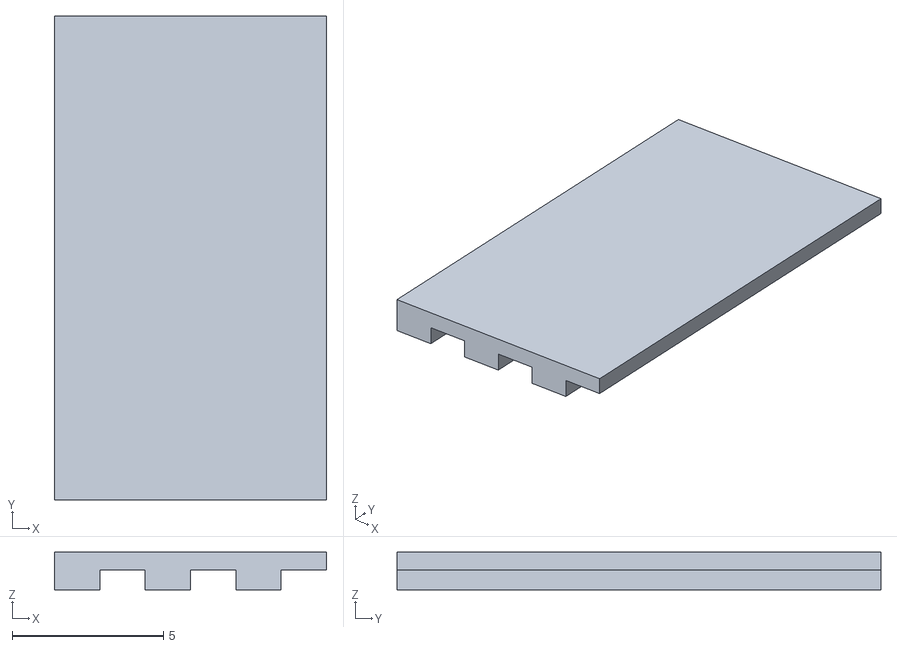
[picture p42: CAD file, 2026-10-30]
stl/master_v4/master_farpad_PLA_v4.stl
9.00 x 16.0 x 1.25
