chaseab/so101-toolchanger/stl/tool_gt1/gt_rotor.stl

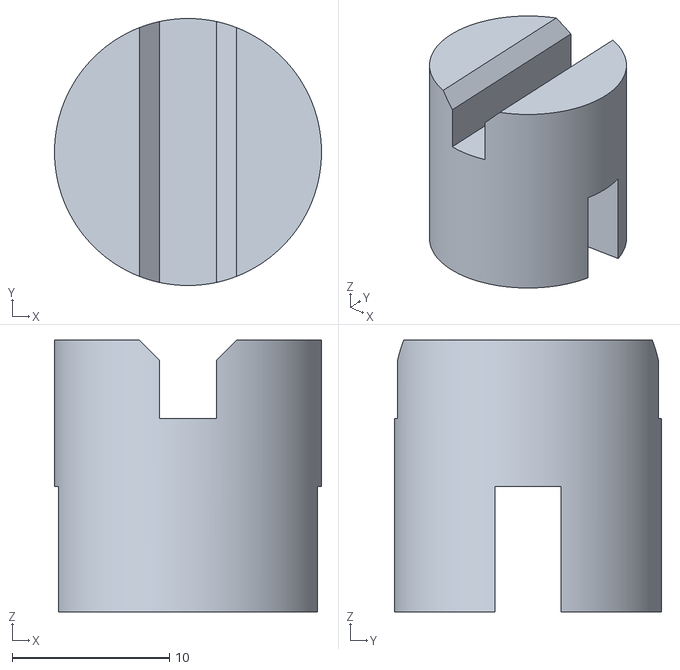
[picture p43: CAD file, 2026-10-30]
stl/tool_gt1/gt_rotor.stl
17.0 x 17.0 x 17.3
