chaseab/so101-toolchanger/stl/master_v4/master_skirt_v4.stl

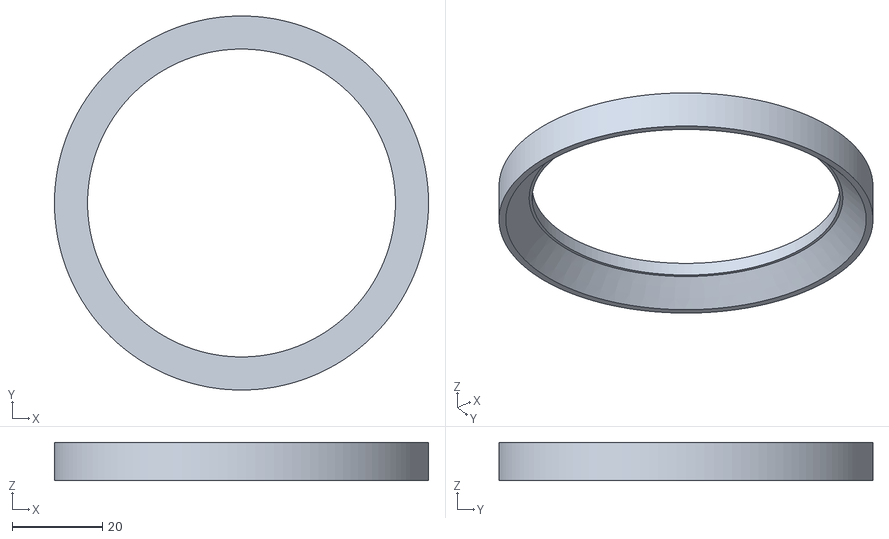
[picture p44: CAD file, 2026-10-30]
stl/master_v4/master_skirt_v4.stl
83.0 x 83.0 x 8.50
