chaseab/so101-toolchanger/stl/tool_gt1/gt_pinion.stl

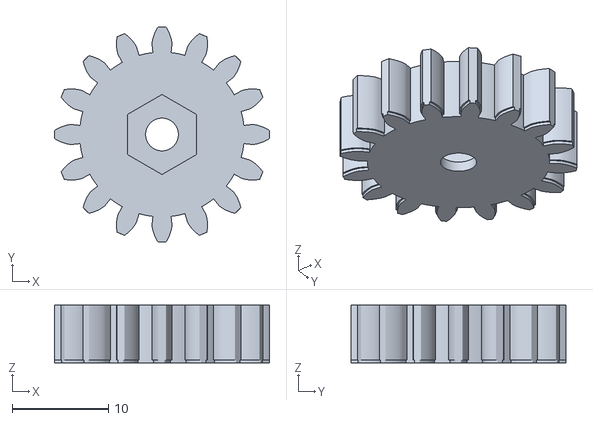
[picture p45: CAD file, 2026-10-30]
stl/tool_gt1/gt_pinion.stl
22.3 x 22.3 x 6.00
