chaseab/so101-toolchanger/stl/heads_jg2/hw_pin3.stl

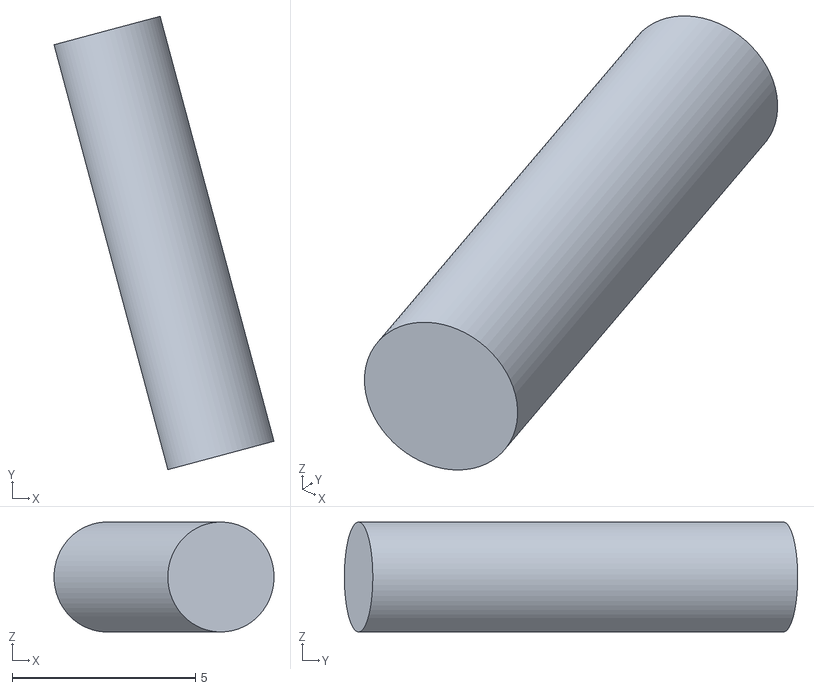
[picture p46: CAD file, 2026-10-30]
stl/heads_jg2/hw_pin3.stl
6.00 x 12.4 x 3.00
