chaseab/so101-toolchanger/stl/tool_fr1/finray2_open.stl

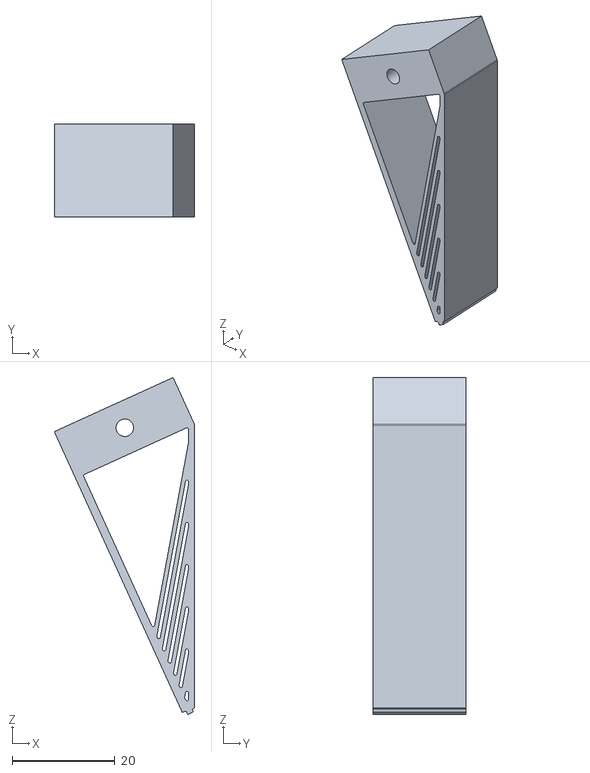
[picture p47: CAD file, 2026-10-30]
stl/tool_fr1/finray2_open.stl
27.3 x 18.0 x 65.5
