chaseab/so101-toolchanger/stl/master_v4/master_carrier_v4.stl

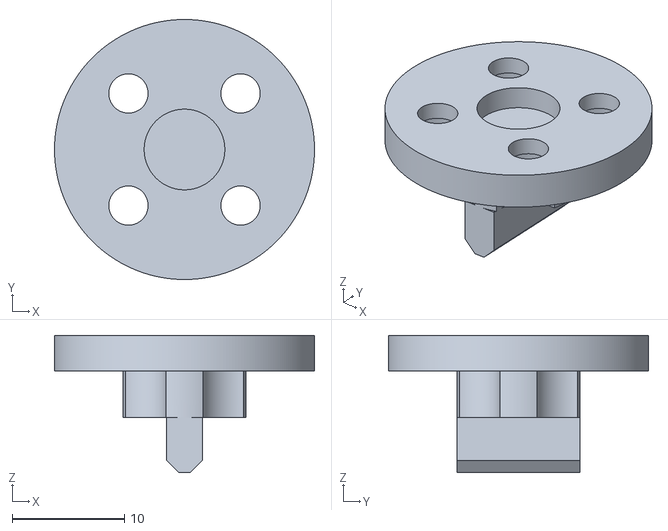
[picture p48: CAD file, 2026-10-30]
stl/master_v4/master_carrier_v4.stl
23.2 x 23.2 x 12.2
