chaseab/so101-toolchanger/stl/heads_jg2/carriage_ret.stl

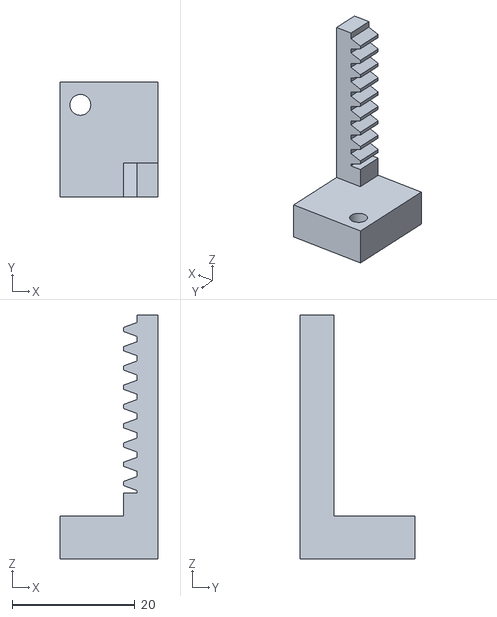
[picture p49: CAD file, 2026-10-30]
stl/heads_jg2/carriage_ret.stl
16.0 x 18.7 x 39.8
