chaseab/so101-toolchanger/stl/heads_stamp2/carriage_closed.stl

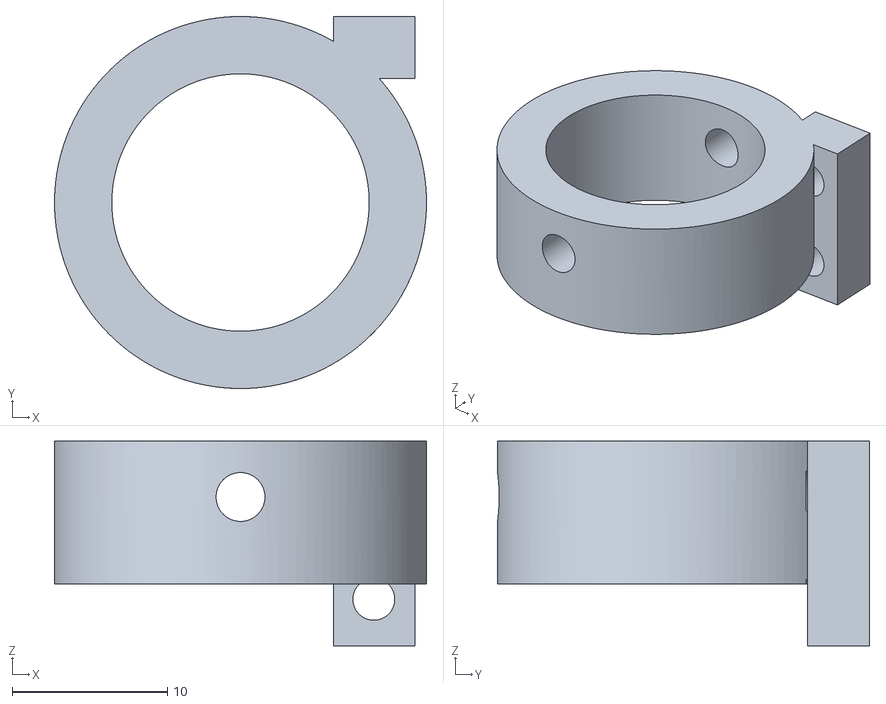
[picture p50: CAD file, 2026-10-30]
stl/heads_stamp2/carriage_closed.stl
24.0 x 24.0 x 13.2
