chaseab/so101-toolchanger/stl/master_v4/db_bar_front.stl

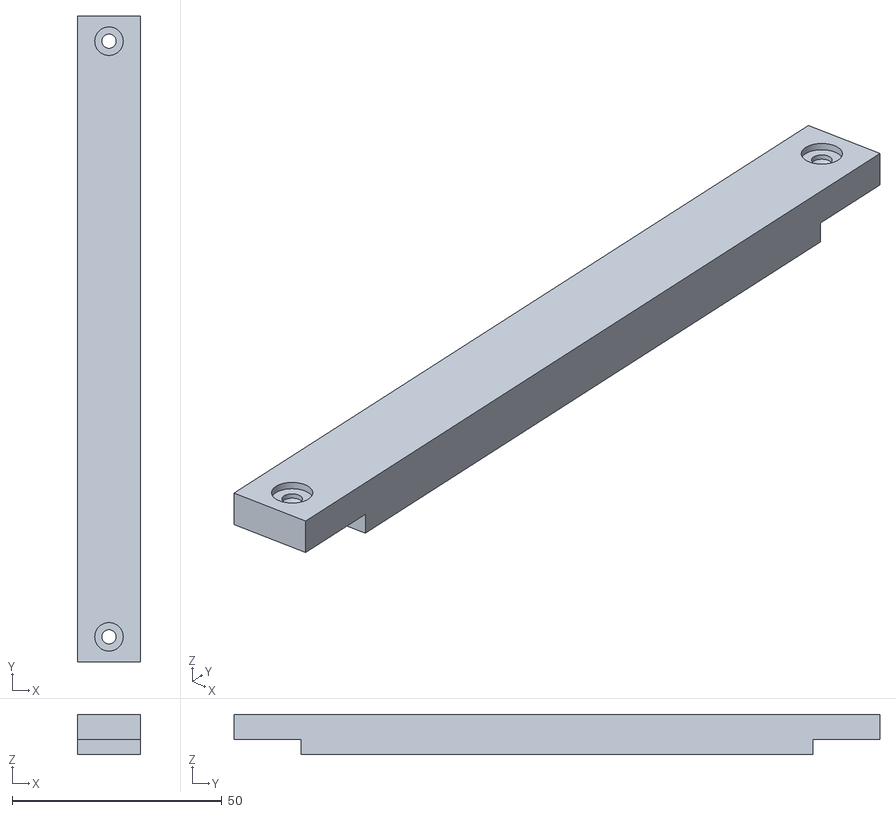
[picture p51: CAD file, 2026-10-30]
stl/master_v4/db_bar_front.stl
15.0 x 154.0 x 9.60
