chaseab/so101-toolchanger/stl/heads_hi5f/hand.stl

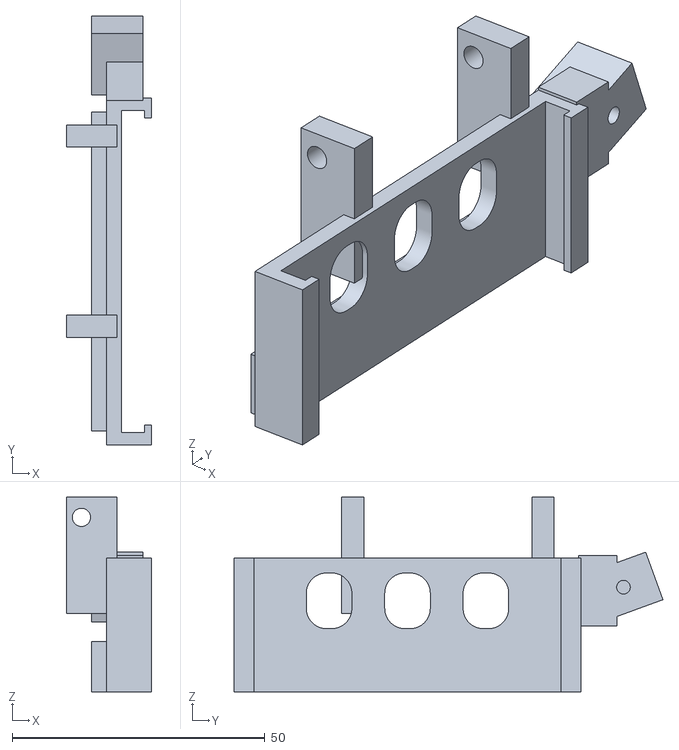
[picture p52: CAD file, 2026-10-30]
stl/heads_hi5f/hand.stl
16.9 x 84.8 x 38.5
