chaseab/so101-toolchanger/stl/heads_stamp2/hw_pin1.stl

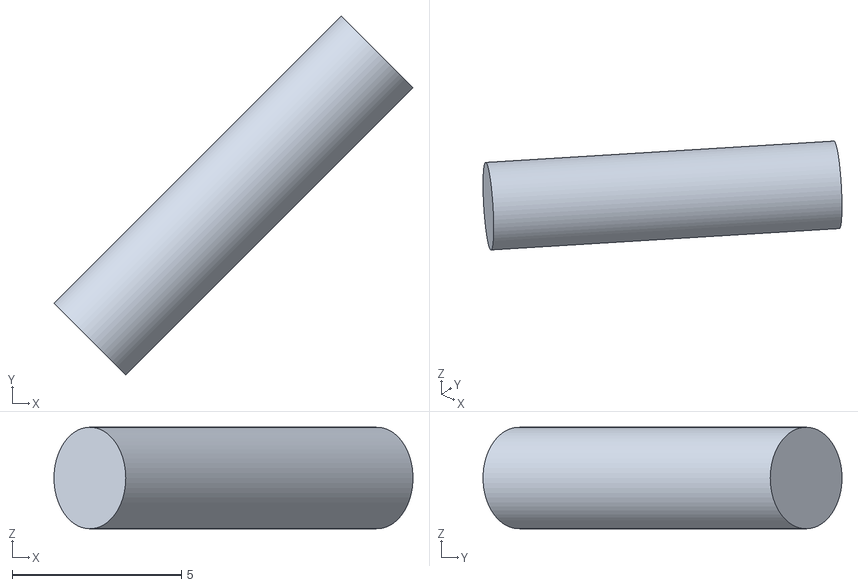
[picture p53: CAD file, 2026-10-30]
stl/heads_stamp2/hw_pin1.stl
10.6 x 10.6 x 3.00
