chaseab/so101-toolchanger/stl/master_v4/master_backpad_TPU_v4.stl

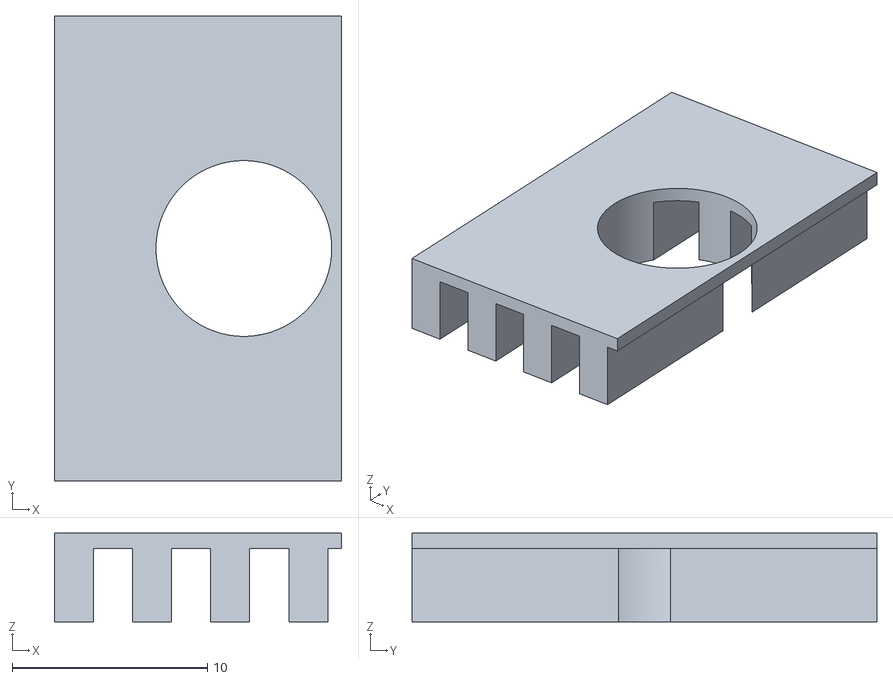
[picture p54: CAD file, 2026-10-30]
stl/master_v4/master_backpad_TPU_v4.stl
14.7 x 23.8 x 4.55
