chaseab/so101-toolchanger/stl/master_v4/master_strap_v4.stl

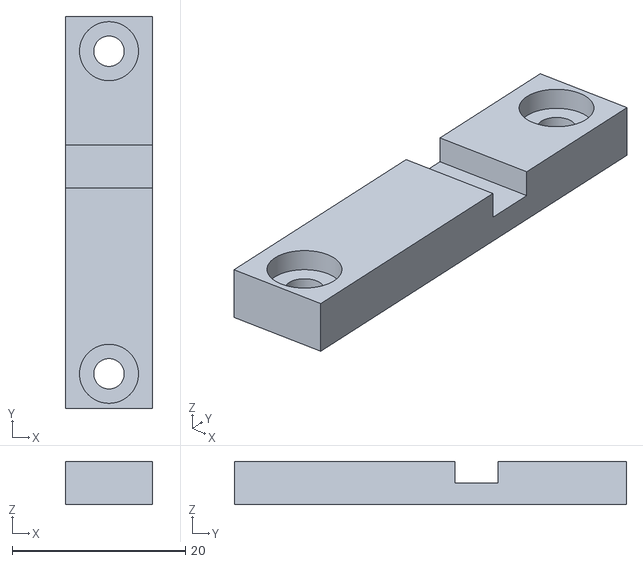
[picture p55: CAD file, 2026-10-30]
stl/master_v4/master_strap_v4.stl
10.0 x 45.2 x 5.00
