chaseab/so101-toolchanger/stl/tool_fr1/cover.stl

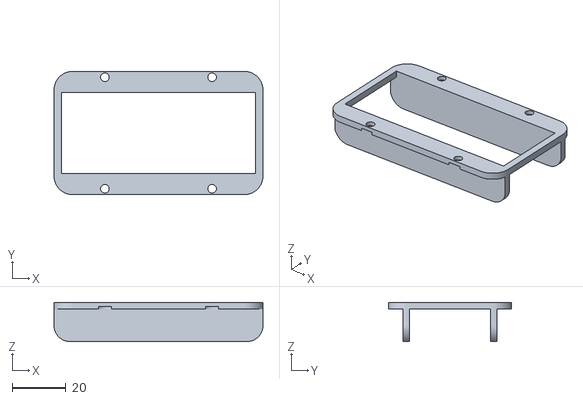
[picture p56: CAD file, 2026-10-30]
stl/tool_fr1/cover.stl
78.0 x 46.0 x 14.6
