chaseab/so101-toolchanger/stl/master_v4/master_farpad_TPU_v4.stl

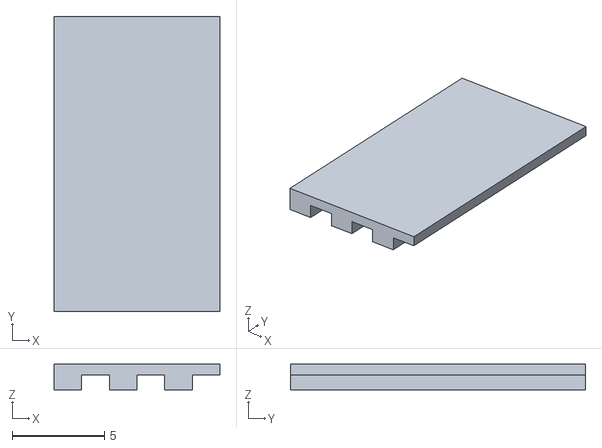
[picture p57: CAD file, 2026-10-30]
stl/master_v4/master_farpad_TPU_v4.stl
9.00 x 16.0 x 1.40
