chaseab/so101-toolchanger/stl/master_v4/gripper_body_v4.stl

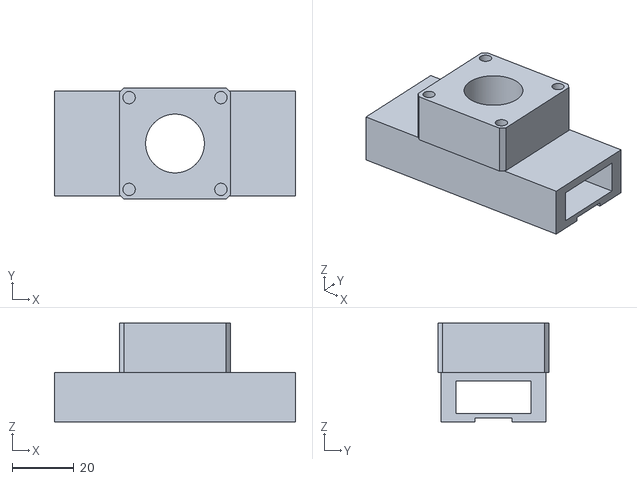
[picture p58: CAD file, 2026-10-30]
stl/master_v4/gripper_body_v4.stl
78.0 x 36.0 x 32.0
