chaseab/so101-toolchanger/stl/heads_jg2/lid.stl

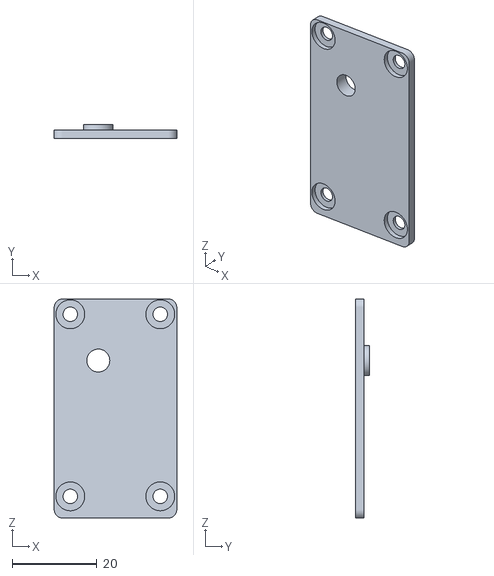
[picture p59: CAD file, 2026-10-30]
stl/heads_jg2/lid.stl
28.9 x 3.40 x 51.6
