chaseab/so101-toolchanger/stl/heads_hi5f/f_ring.stl

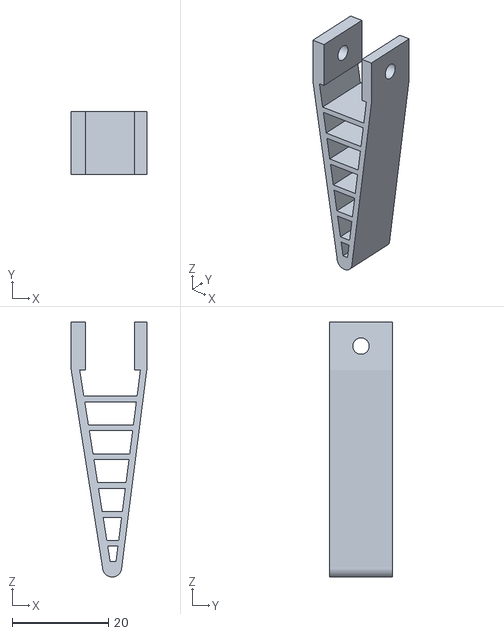
[picture p60: CAD file, 2026-10-30]
stl/heads_hi5f/f_ring.stl
15.7 x 13.0 x 53.0
