chaseab/so101-toolchanger/stl/heads_jg2/hub_ret.stl

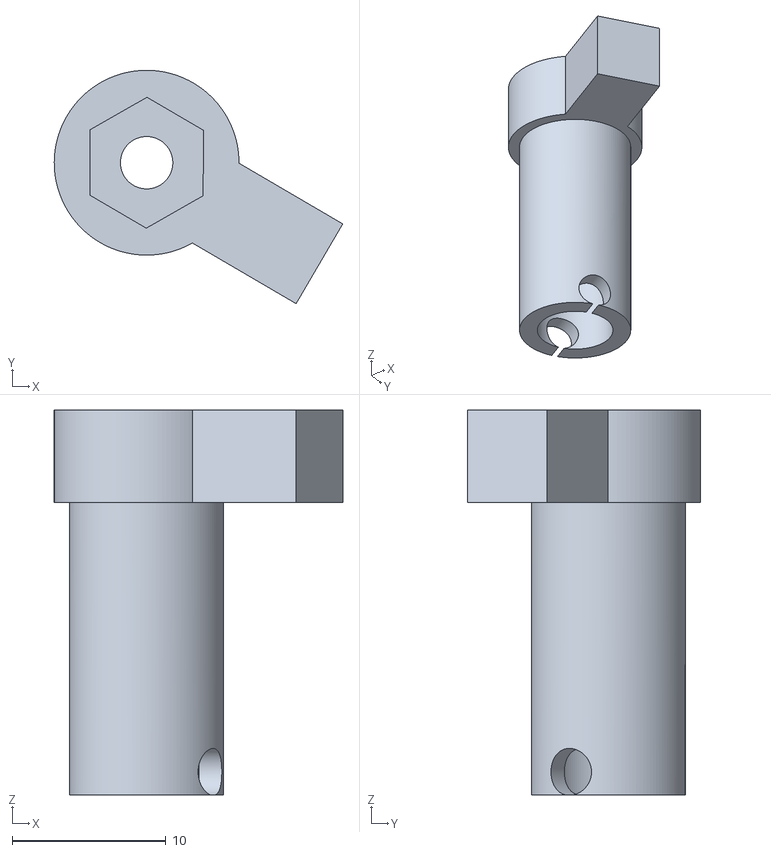
[picture p61: CAD file, 2026-10-30]
stl/heads_jg2/hub_ret.stl
18.7 x 15.2 x 25.0
