chaseab/so101-toolchanger/stl/master_v4/master_cage_v4.stl

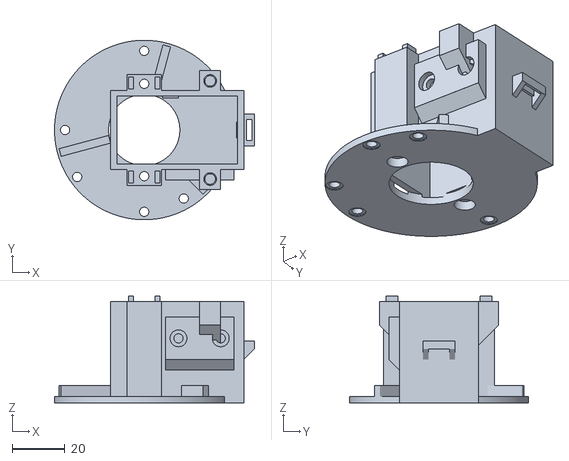
[picture p62: CAD file, 2026-10-30]
stl/master_v4/master_cage_v4.stl
75.8 x 68.0 x 40.4
