chaseab/so101-toolchanger/stl/heads_stamp2/hub_closed.stl

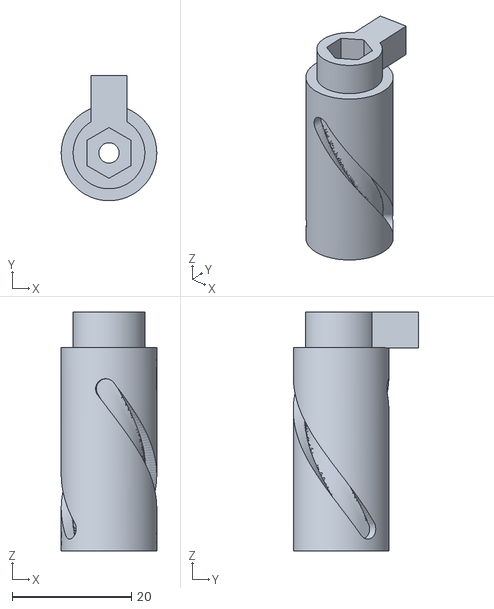
[picture p63: CAD file, 2026-10-30]
stl/heads_stamp2/hub_closed.stl
16.0 x 21.0 x 40.0
