chaseab/so101-toolchanger/stl/master_v4/master_dowels_v4.stl

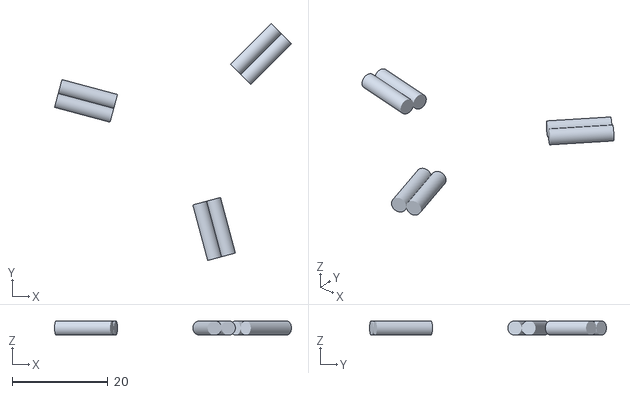
[picture p64: CAD file, 2026-10-30]
stl/master_v4/master_dowels_v4.stl
49.4 x 49.4 x 3.00
