chaseab/so101-toolchanger/stl/heads_hi5f/drive_pins.stl

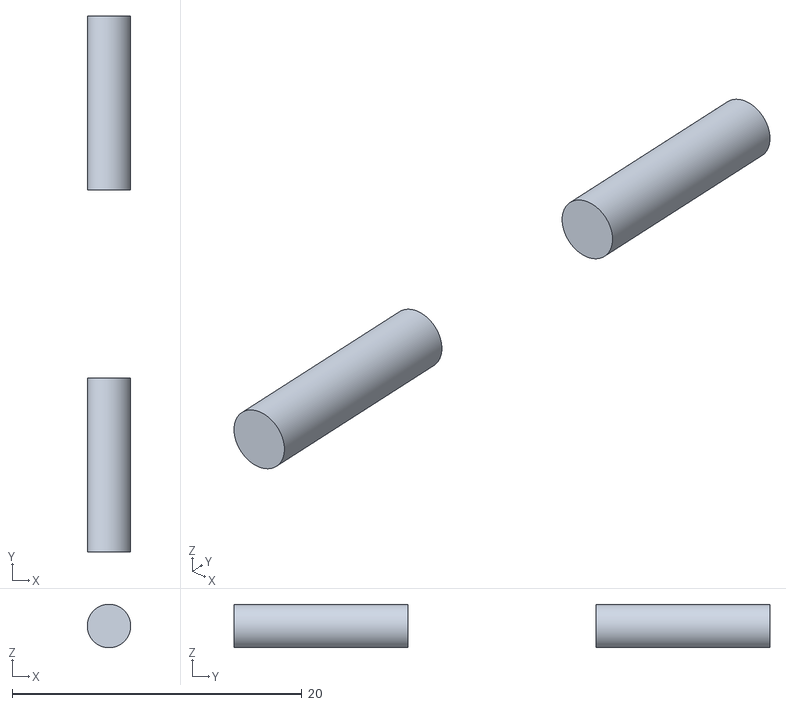
[picture p65: CAD file, 2026-10-30]
stl/heads_hi5f/drive_pins.stl
3.00 x 37.0 x 3.00
