chaseab/so101-toolchanger/stl/heads_hi5f/carriage.stl

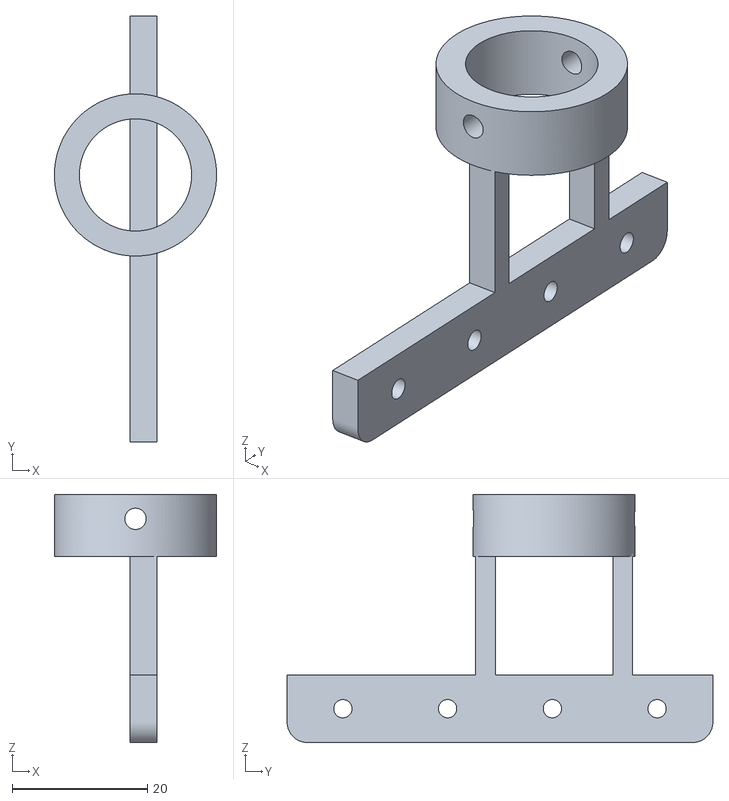
[picture p66: CAD file, 2026-10-30]
stl/heads_hi5f/carriage.stl
24.0 x 63.0 x 36.7
