chaseab/so101-toolchanger/stl/heads_stamp2/rack_closed.stl

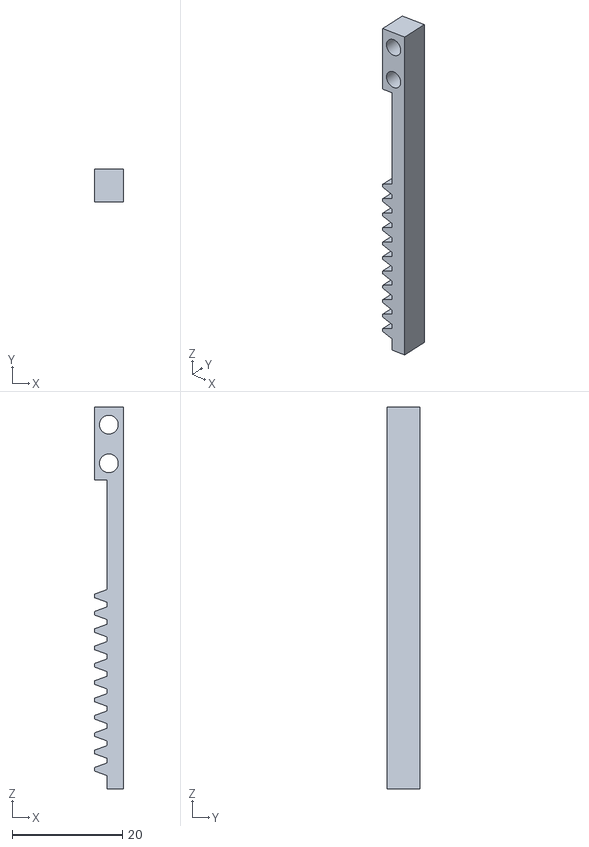
[picture p67: CAD file, 2026-10-30]
stl/heads_stamp2/rack_closed.stl
5.25 x 6.00 x 69.2
