chaseab/so101-toolchanger/stl/heads_hi5f/f_index_closed.stl

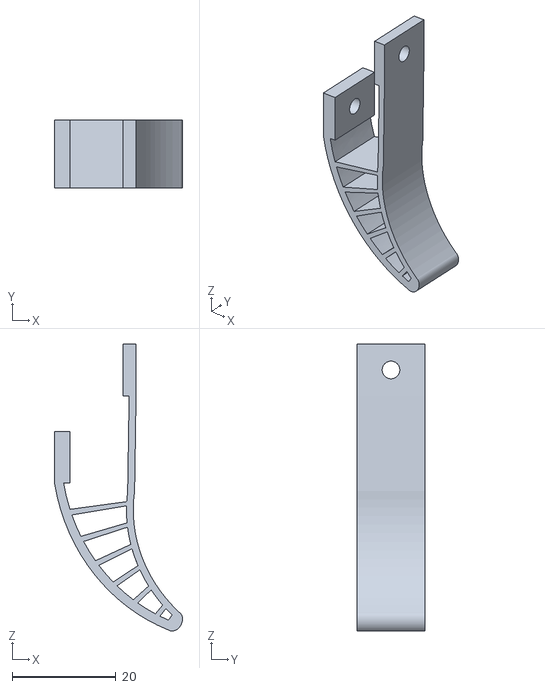
[picture p68: CAD file, 2026-10-30]
stl/heads_hi5f/f_index_closed.stl
24.6 x 13.0 x 55.2
