chaseab/so101-toolchanger/stl/heads_jg2/a_dowel.stl

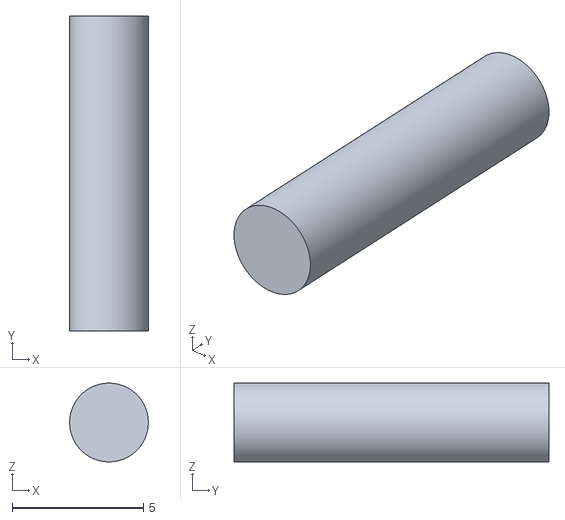
[picture p69: CAD file, 2026-10-30]
stl/heads_jg2/a_dowel.stl
3.00 x 12.0 x 3.00
