chaseab/so101-toolchanger/stl/heads_jg2/nose.stl

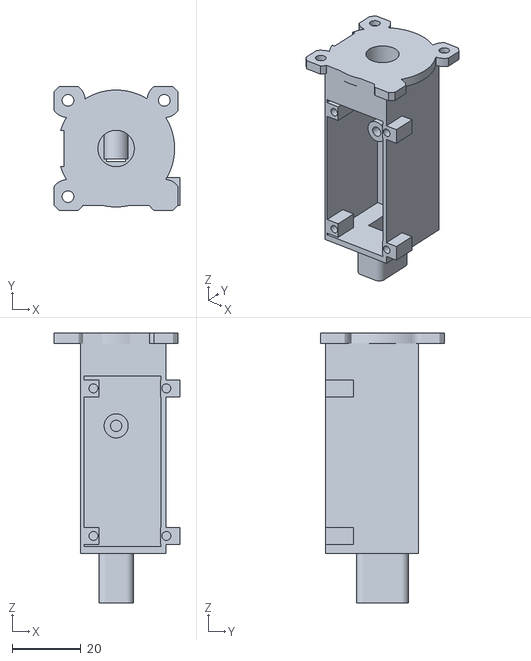
[picture p70: CAD file, 2026-10-30]
stl/heads_jg2/nose.stl
36.5 x 36.0 x 78.5
