chaseab/so101-toolchanger/stl/heads_jg2/hub.stl

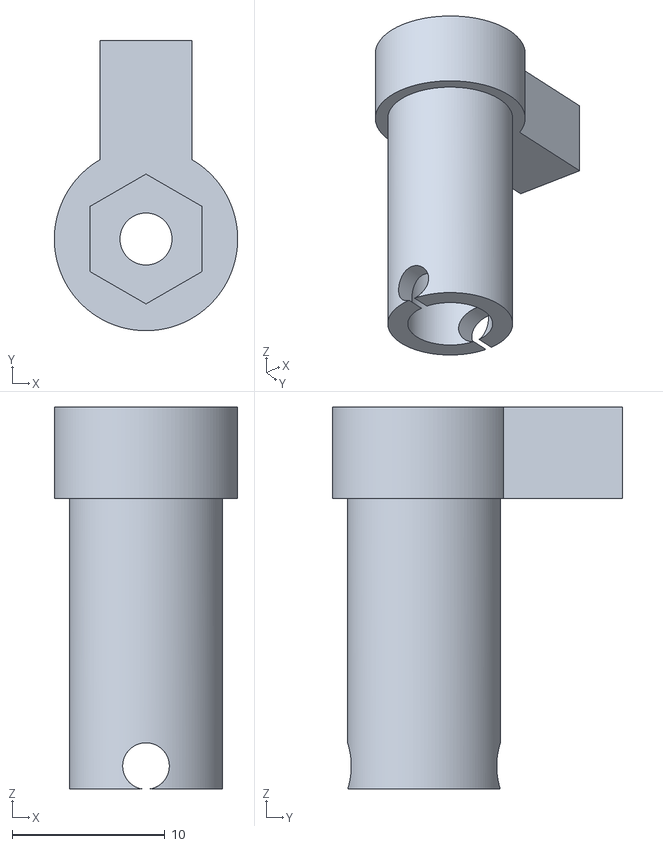
[picture p71: CAD file, 2026-10-30]
stl/heads_jg2/hub.stl
12.0 x 19.0 x 25.0
