chaseab/so101-toolchanger/stl/heads_hi5f/shaft.stl

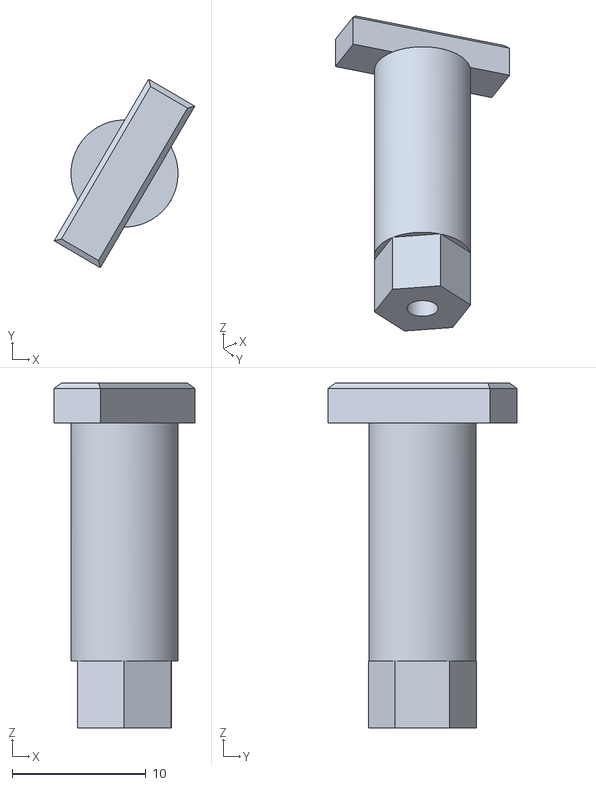
[picture p72: CAD file, 2026-10-30]
stl/heads_hi5f/shaft.stl
10.5 x 14.1 x 25.8
