chaseab/so101-toolchanger/stl/heads_hi5f/hub.stl

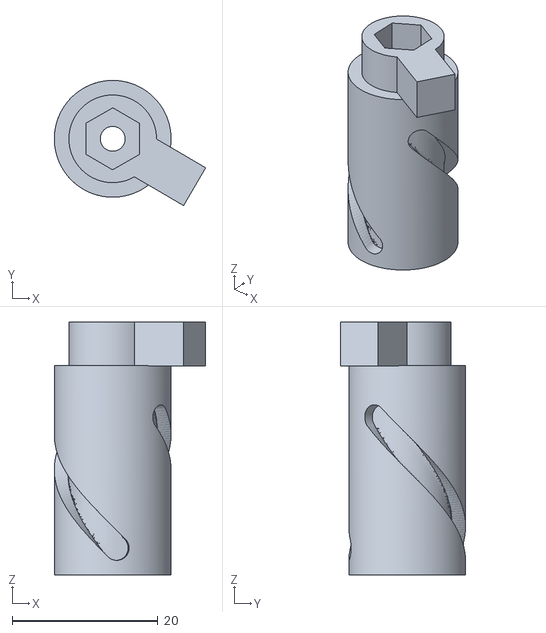
[picture p73: CAD file, 2026-10-30]
stl/heads_hi5f/hub.stl
20.7 x 17.1 x 34.7
