chaseab/so101-toolchanger/stl/heads_stamp2/die_rotor_closed.stl

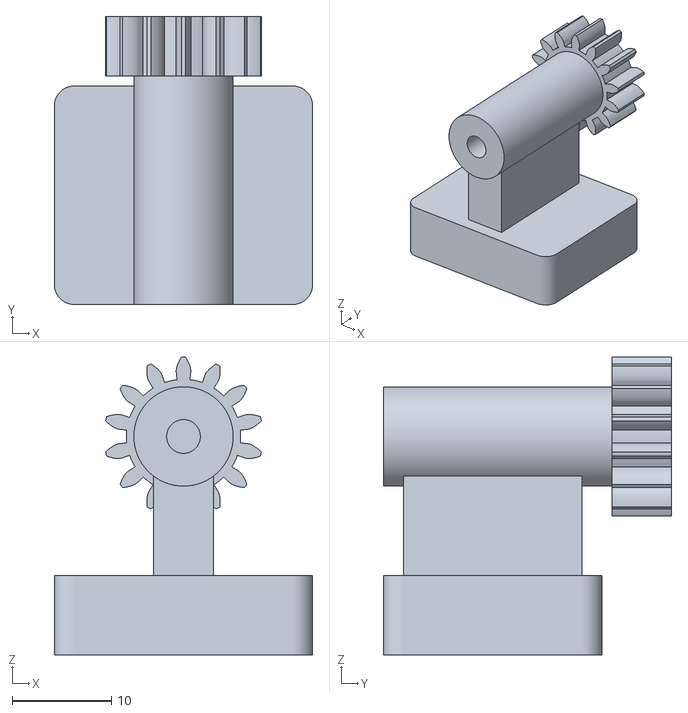
[picture p74: CAD file, 2026-10-30]
stl/heads_stamp2/die_rotor_closed.stl
26.0 x 29.0 x 30.0
