chaseab/so101-toolchanger/stl/heads_jg2/a_dowel_ret.stl

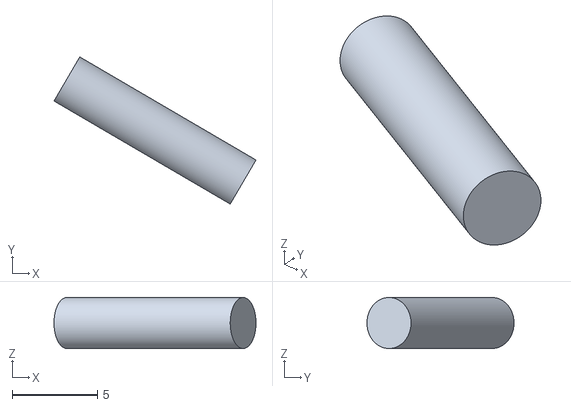
[picture p75: CAD file, 2026-10-30]
stl/heads_jg2/a_dowel_ret.stl
11.9 x 8.65 x 3.00
