chaseab/so101-toolchanger/stl/heads_hi5f/f_pinky_closed.stl

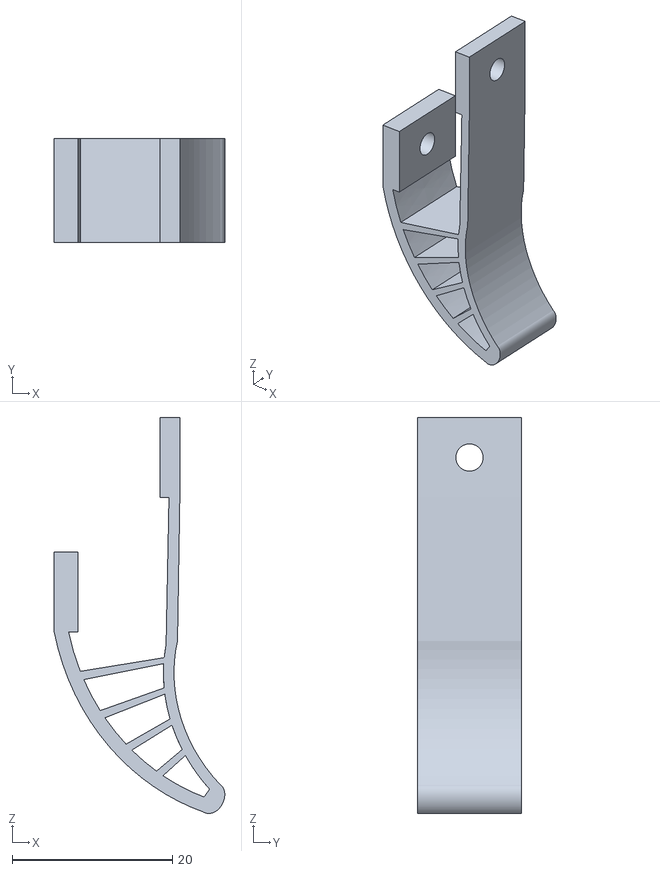
[picture p76: CAD file, 2026-10-30]
stl/heads_hi5f/f_pinky_closed.stl
21.3 x 13.0 x 49.5
