chaseab/so101-toolchanger/stl/heads_stamp2/frame.stl

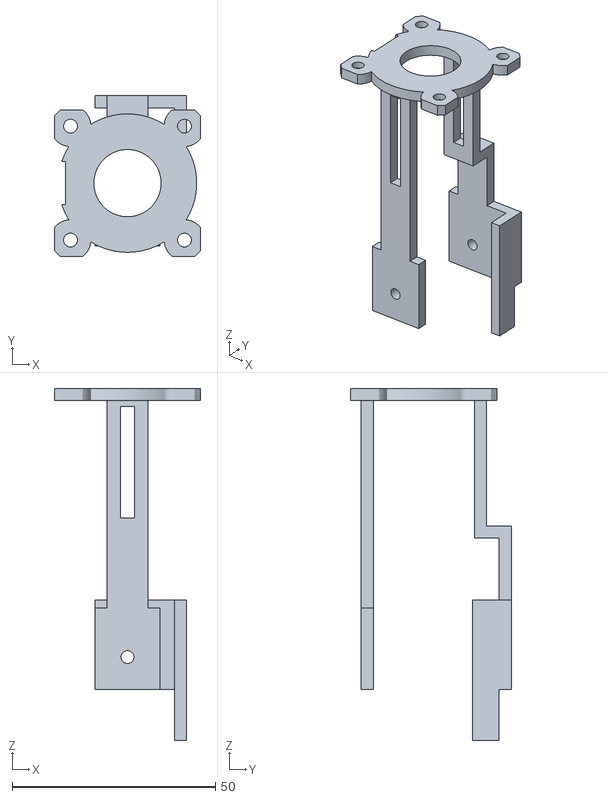
[picture p77: CAD file, 2026-10-30]
stl/heads_stamp2/frame.stl
36.0 x 39.5 x 86.5
