chaseab/so101-toolchanger/stl/heads_hi5f/f_index.stl

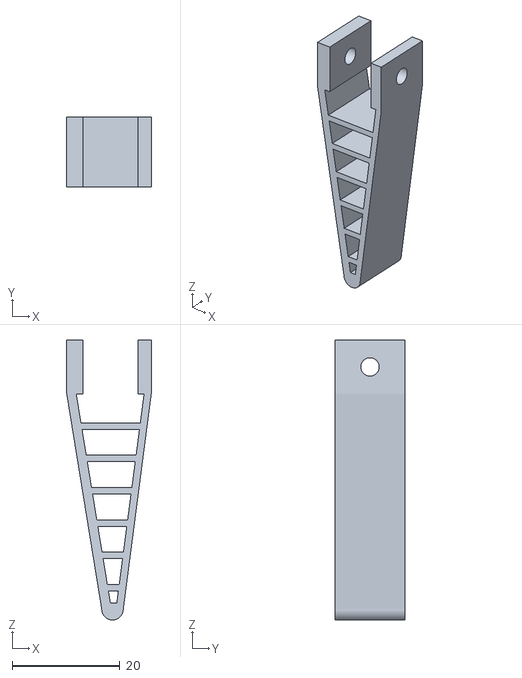
[picture p78: CAD file, 2026-10-30]
stl/heads_hi5f/f_index.stl
15.7 x 13.0 x 52.0
