chaseab/so101-toolchanger/stl/heads_hi5f/hub_closed.stl

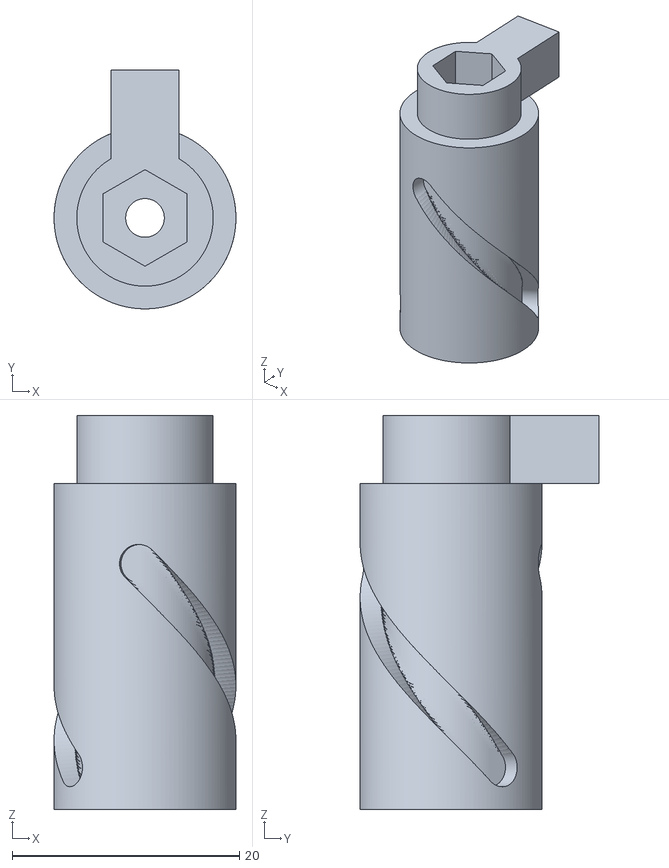
[picture p79: CAD file, 2026-10-30]
stl/heads_hi5f/hub_closed.stl
16.0 x 21.0 x 34.7
