chaseab/so101-toolchanger/stl/heads_hi5f/f_middle.stl

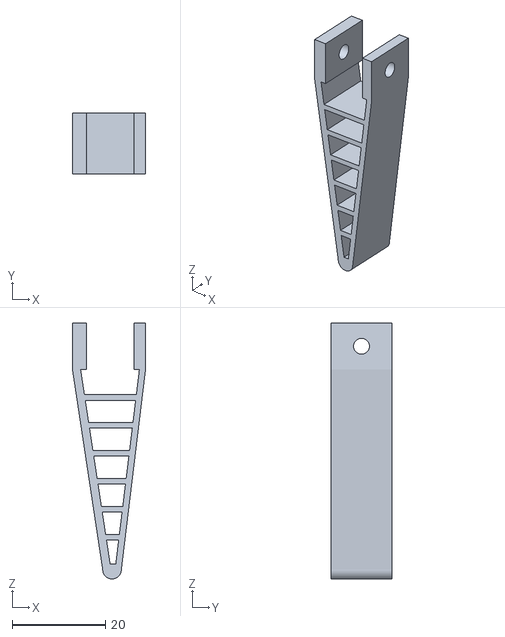
[picture p80: CAD file, 2026-10-30]
stl/heads_hi5f/f_middle.stl
15.7 x 13.0 x 55.0
