chaseab/so101-toolchanger/stl/heads_hi5f/f_middle_closed.stl

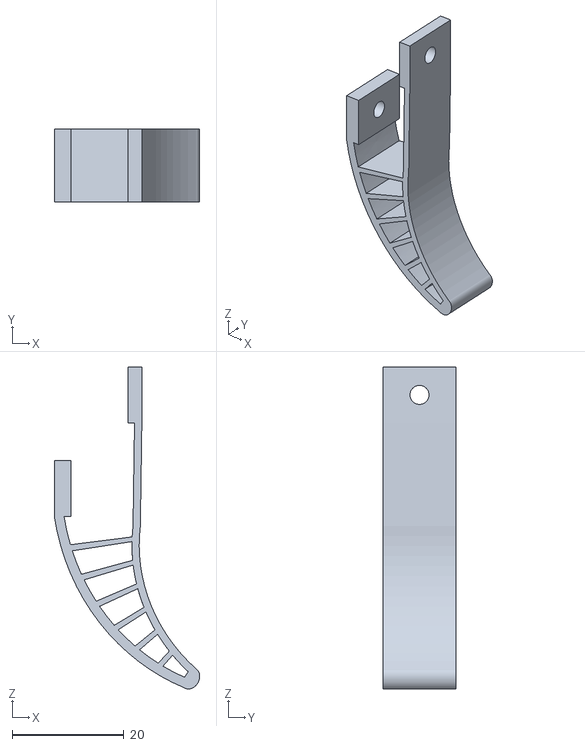
[picture p81: CAD file, 2026-10-30]
stl/heads_hi5f/f_middle_closed.stl
26.1 x 13.0 x 57.7
