chaseab/so101-toolchanger/stl/heads_hi5f/f_thumb.stl

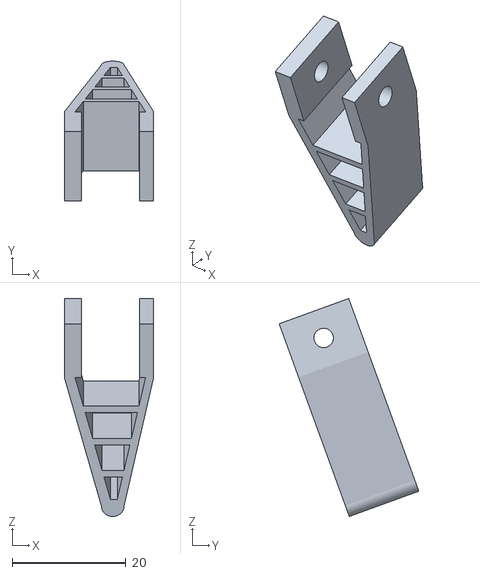
[picture p82: CAD file, 2026-10-30]
stl/heads_hi5f/f_thumb.stl
15.7 x 24.5 x 38.3
