chaseab/so101-toolchanger/stl/heads_stamp2/hub.stl

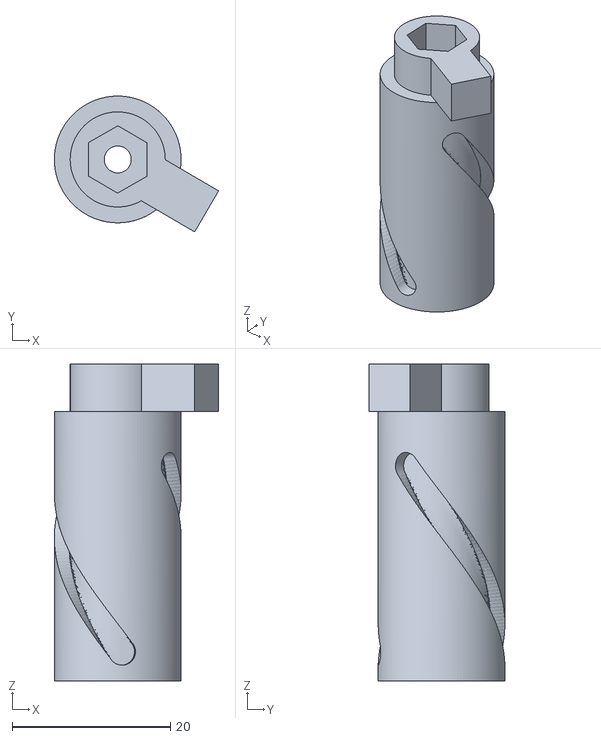
[picture p83: CAD file, 2026-10-30]
stl/heads_stamp2/hub.stl
20.7 x 17.1 x 40.0
