chaseab/so101-toolchanger/(list of files, cad)

Other CAD files:
step/dock_v5/cradle_col_R.step
stl/dock_v5/dock_post_asbuilt.stl
stl/master_v4/master_ring_v4q.stl
step/dock_v5/stop_pad.step
stl/dock_v5/stop_pad_R.stl
stl/heads_jg2/hw_neck_insert2.stl
stl/master_v4/master_plunger0_v4b.stl
stl/tool_fr1/jaw1.stl
stl/tool_gt1/gt_pins.stl
stl/tool_fr1/shaft.stl
stl/tool_fr1/jaw2.stl
stl/heads_jg2/hw_housing_insert4.stl
stl/tool_fr1/rotor.stl
stl/heads_stamp2/hw_pin2.stl
stl/master_v4/master_plunger1_v4b.stl
stl/tool_gt1/gt_plate.stl
stl/tool_fr1/finray1_open.stl
stl/tool_gt1/gt_jaw2.stl
stl/heads_hi5f/hw_housing_insert3.stl
stl/tool_fr1/pinion.stl
stl/tool_fr1/jaw1_open.stl
stl/heads_jg2/rotor_ret.stl
stl/heads_stamp2/rotor_closed.stl
stl/heads_jg2/rod.stl
stl/heads_stamp2/die_cap_closed.stl
stl/tool_fr1/finray1.stl
stl/heads_jg2/shaft.stl
stl/tool_fr1/finray2.stl
stl/heads_stamp2/hw_neck_insert1.stl
stl/heads_jg2/rotor.stl
stl/heads_stamp2/drive_pins_closed.stl
stl/heads_hi5f/hw_housing_insert4.stl
stl/heads_jg2/hw_neck_insert1.stl
stl/heads_stamp2/shaft_closed.stl
stl/heads_jg2/pinion_unit_ret.stl
stl/heads_stamp2/drive_pins.stl
stl/heads_jg2/hw_neck_insert4.stl
stl/heads_stamp2/hw_housing_insert3.stl
stl/heads_hi5f/hw_pin2.stl
stl/heads_stamp2/axle_dowels.stl
stl/heads_hi5f/carriage_closed.stl
stl/heads_jg2/bevel_a.stl
stl/heads_jg2/hw_housing_insert2.stl
stl/heads_jg2/hw_neck_insert3.stl
stl/heads_jg2/hw_housing_insert3.stl
stl/heads_stamp2/hw_neck_insert2.stl
stl/heads_hi5f/hw_neck_insert1.stl
stl/heads_hi5f/hw_housing_insert2.stl
stl/heads_jg2/shaft_ret.stl
stl/heads_jg2/hw_pin2.stl
stl/heads_jg2/carriage.stl
stl/heads_stamp2/rack.stl
stl/heads_stamp2/rotor.stl
stl/heads_stamp2/hw_neck_insert3.stl
stl/heads_hi5f/drive_pins_closed.stl
stl/heads_stamp2/hw_neck_insert4.stl
stl/heads_stamp2/hw_housing_insert2.stl
stl/heads_stamp2/hw_housing_insert4.stl
stl/heads_hi5f/hw_neck_insert2.stl
stl/heads_stamp2/die_rotor.stl
stl/dock_v5/cradle_col_L.stl
stl/dock_v5/cradle_col_R.stl
stl/dock_v5/head_R2.stl
stl/dock_v5/stop_pad.stl
stl/dock_v5/t_gauge.stl
stl/heads_hi5f/frame.stl
stl/heads_hi5f/hw_back_screw_index.stl
stl/heads_hi5f/hw_back_screw_middle.stl
stl/heads_hi5f/hw_back_screw_pinky.stl
stl/heads_hi5f/hw_back_screw_ring.stl
stl/heads_hi5f/hw_back_screw_thumb.stl
stl/heads_hi5f/hw_cap_screw1.stl
stl/heads_hi5f/hw_cap_screw2.stl
stl/heads_hi5f/hw_cap_screw3.stl
stl/heads_hi5f/hw_cap_screw4.stl
stl/heads_hi5f/hw_joint_screw1.stl
stl/heads_hi5f/hw_joint_screw2.stl
stl/heads_hi5f/hw_neck_insert3.stl
stl/heads_hi5f/hw_neck_insert4.stl
stl/heads_hi5f/hw_palm_screw_index.stl
stl/heads_hi5f/hw_palm_screw_index_closed.stl
stl/heads_hi5f/hw_palm_screw_middle.stl
stl/heads_hi5f/hw_palm_screw_middle_closed.stl
stl/heads_hi5f/hw_palm_screw_pinky.stl
stl/heads_hi5f/hw_palm_screw_pinky_closed.stl
stl/heads_hi5f/hw_palm_screw_ring.stl
stl/heads_hi5f/hw_palm_screw_ring_closed.stl
stl/heads_hi5f/hw_palm_screw_thumb.stl
stl/heads_hi5f/hw_plate_screw1.stl
stl/heads_hi5f/hw_plate_screw2.stl
stl/heads_hi5f/hw_plate_screw3.stl
stl/heads_hi5f/hw_plate_screw4.stl
stl/heads_hi5f/hw_shaft_screw.stl
stl/heads_hi5f/hw_shaft_screw_closed.stl
stl/heads_hi5f/hw_shaft_washer.stl
stl/heads_hi5f/hw_shaft_washer_closed.stl
stl/heads_hi5f/rotor.stl
stl/heads_hi5f/rotor_closed.stl
stl/heads_hi5f/shaft_closed.stl
stl/heads_jg2/hw_cap_screw1.stl
stl/heads_jg2/hw_cap_screw2.stl
stl/heads_jg2/hw_cap_screw3.stl
stl/heads_jg2/hw_lid_screw1.stl
stl/heads_jg2/hw_lid_screw2.stl
stl/heads_jg2/hw_lid_screw3.stl
stl/heads_jg2/hw_lid_screw4.stl
stl/heads_jg2/hw_plate_screw1.stl
stl/heads_jg2/hw_plate_screw2.stl
stl/heads_jg2/hw_plate_screw3.stl
stl/heads_jg2/hw_plate_screw4.stl
stl/heads_jg2/hw_rod_screw.stl
stl/heads_jg2/hw_rod_screw_ret.stl
stl/heads_jg2/hw_shaft_screw.stl
stl/heads_jg2/hw_shaft_screw_ret.stl
stl/heads_jg2/hw_shaft_washer.stl
stl/heads_jg2/hw_shaft_washer_ret.stl
stl/heads_stamp2/carriage.stl
stl/heads_stamp2/hw_cap_screw1.stl
stl/heads_stamp2/hw_cap_screw2.stl
stl/heads_stamp2/hw_cap_screw3.stl
stl/heads_stamp2/hw_cap_screw4.stl
stl/heads_stamp2/hw_face_screw1.stl
stl/heads_stamp2/hw_face_screw1_closed.stl
stl/heads_stamp2/hw_face_screw2.stl
stl/heads_stamp2/hw_face_screw2_closed.stl
stl/heads_stamp2/hw_face_screw3.stl
stl/heads_stamp2/hw_face_screw3_closed.stl
stl/heads_stamp2/hw_face_screw4.stl
stl/heads_stamp2/hw_face_screw4_closed.stl
stl/heads_stamp2/hw_plate_screw1.stl
stl/heads_stamp2/hw_plate_screw2.stl
stl/heads_stamp2/hw_plate_screw3.stl
stl/heads_stamp2/hw_plate_screw4.stl
stl/heads_stamp2/hw_rack_screw1.stl
stl/heads_stamp2/hw_rack_screw1_closed.stl
stl/heads_stamp2/hw_rack_screw2.stl
stl/heads_stamp2/hw_rack_screw2_closed.stl
stl/heads_stamp2/hw_shaft_screw.stl
stl/heads_stamp2/hw_shaft_screw_closed.stl
stl/heads_stamp2/hw_shaft_washer.stl
stl/heads_stamp2/hw_shaft_washer_closed.stl
stl/master_v4/dock_post_v4.stl
