chaseab/so101-toolchanger/docs/future_tools/fr1_assembled.png

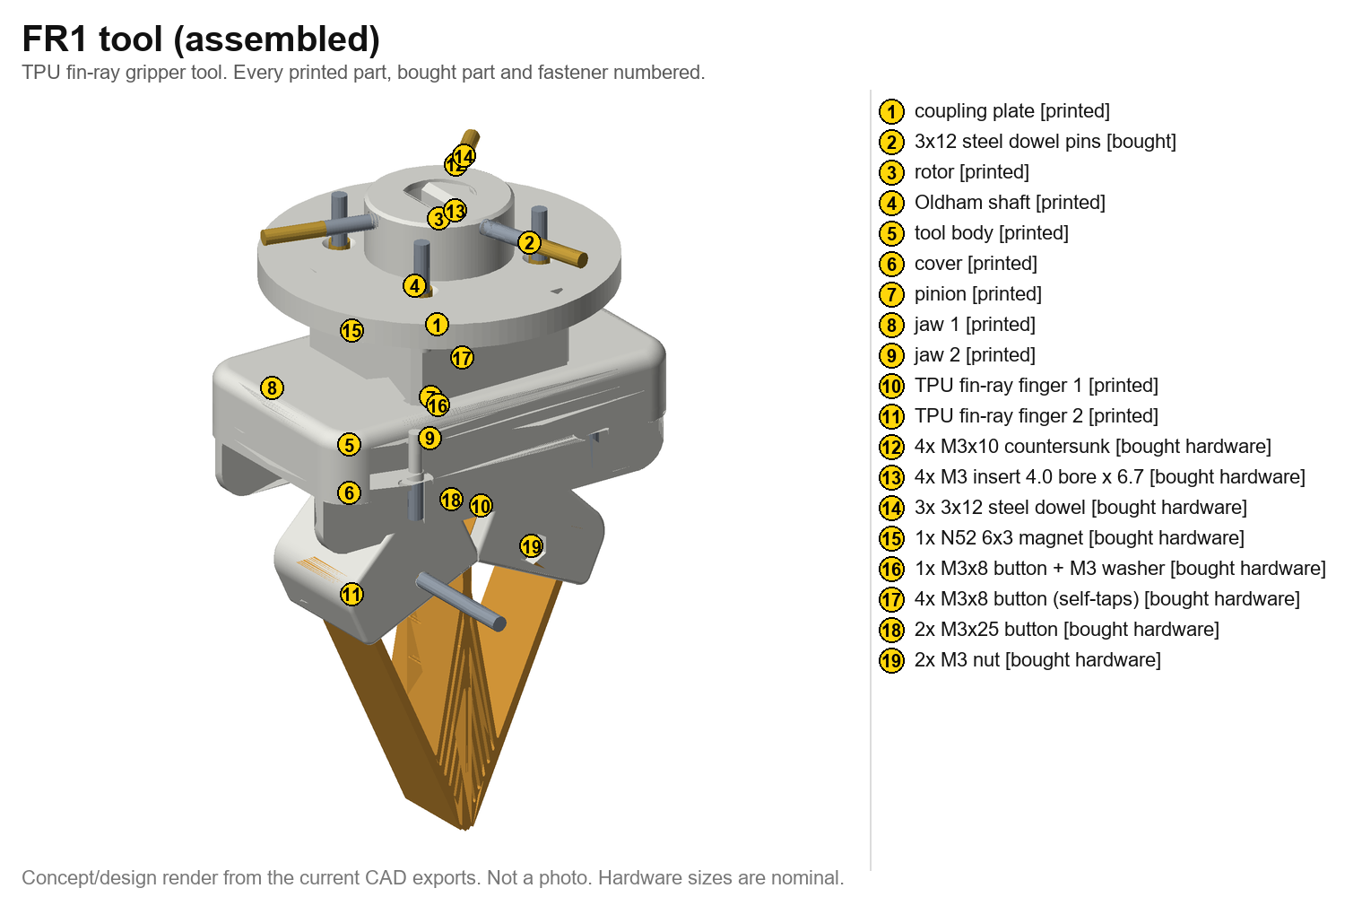
docs/future_tools/fr1_assembled.png
