chaseab/so101-toolchanger/docs/future_tools/jg2_assembled.png

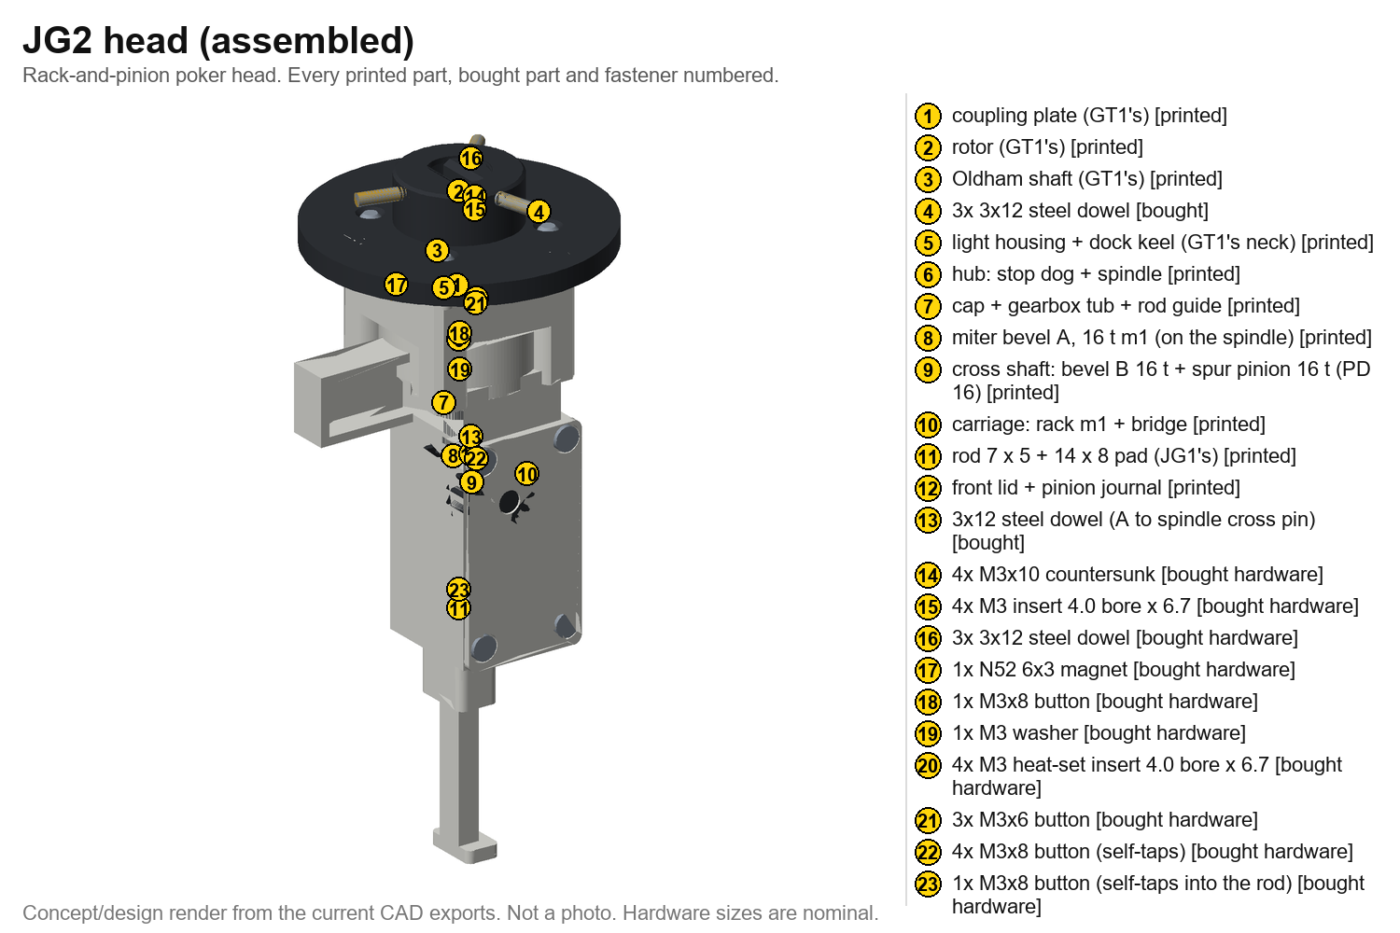
docs/future_tools/jg2_assembled.png
