chaseab/so101-toolchanger/(commit log)

2026-10-30 SO-101 tool changer design files (work in progress)
    Focus on the tool changer: exploded diagram, twist-lock sequence, dock retrofit diagram, BOM ordered core first. CAD-as-code, STEP/STL, swap control code, sim model, docs.
    Hardware and docs CC BY-NC-SA 4.0; code GPL-3.0-or-later.
    [BOM.csv, a_dowel.stl, a_dowel_ret.stl, axle_dowels.stl, bevel_a.stl, bevel_a_ret.stl, body.stl, carriage.stl]
2026-10-30 Recount BOM: 20 printed parts per build, exact links, manual-swap video
    BOM restructured into A (one tool changer), B (per extra tool), C (optional/future).
    README summary fixed; manual swap clip added first in the Video section.
    [BOM.csv]
2026-10-30 BOM: fix per-extra-tool (section B) used_for text
    [BOM.csv]
2026-11-03 Relicense as open hardware (CERN-OHL-W-2.0), dated n100 status, add trial data
    - Hardware CAD/STL/STEP/drawings: CC BY-NC-SA 4.0 -> CERN-OHL-W-2.0 (OSHWA-compatible); SPDX headers in cad/ updated
    - Docs and data: CC BY 4.0; code stays GPL-3.0-or-later
    - README status from SCOREBOARD (Nov 2 n100): 100/100 first-try picks (wiggle-tested), 99/100 put-backs,
    1 abort = false servo temperature reading, 0 docking failures, median cycle 29.6 s; scope limits stated
    - data/: n100 scoreboard rows (206) + per-cycle P11 timing log (102) + column dictionary
    - Future heads (hi5f, jg2, stamp2, fr1) marked out of scope / experimental; missing swap/ deps noted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
    [n100_scoreboard_2026-11-02.csv]
2026-11-03 Add the P11 cycle runner used for the Nov 2 100-cycle run
    - swap/: controller (nudge_web.py, nudge.py), runner (cycle.py, run_path.py), program registry (programs.py,
    programs/P11, paths/prog_P11_*), camera checks/capture (camcheck, capture, capture_cv, capguard)
    - Version used for runs c1102_205018 / c1102_215723, rebuilt from timestamped backups; swap/RUNNER.md lists
    the differences (205018 ran temperature filter v1, committed v2) and what was removed for publication
    - Machine-specific settings moved to swap/tc_config.py + config.example.json (config.json gitignored):
    serial port, capture folder, calibration file, capture python; no local paths, COM ports or user names
    - Vendored spl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
    [camcheck.py, capguard.py, capture.py, capture_cv.py, cycle.py, fk.py, grip_cap.py, jog.py]
2026-11-09 README: lead with the automatic docking cycle, add newer work, fix magnet count
    - Top: 6x GIF of an automatic pick, wiggle check and put-back (Nov 5)
    - Status: 100-cycle run, Nov 5 speed (4 runs), FR1, dock finding, off-angle seating
    - One N52 magnet in the tool neck; the dock-floor magnet is optional
    - Drop the Oct 28 teleop takes and their GIFs (one earlier-footage link kept)
    Claude-Session: https://claude.ai/code/session_01B7aKGrTDodfc1zsJAYjeEY
